CoreyChen922/rggber-hw/README.md

# rggber-hw
Schematics and Bill of Material

- ## rggber-hw/FPGA_CORE_BOARD

  FPGA processor board

- ## rggber-hw/IMAGE_BASE_BOARD

  Image mainboard

- ## rggber-hw/LCD_add_on

  LCD add-on card

- ## rggber-hw/iXCtrl_add_on

  iXCtrl add-on card

- ## RGGBer board level diagram

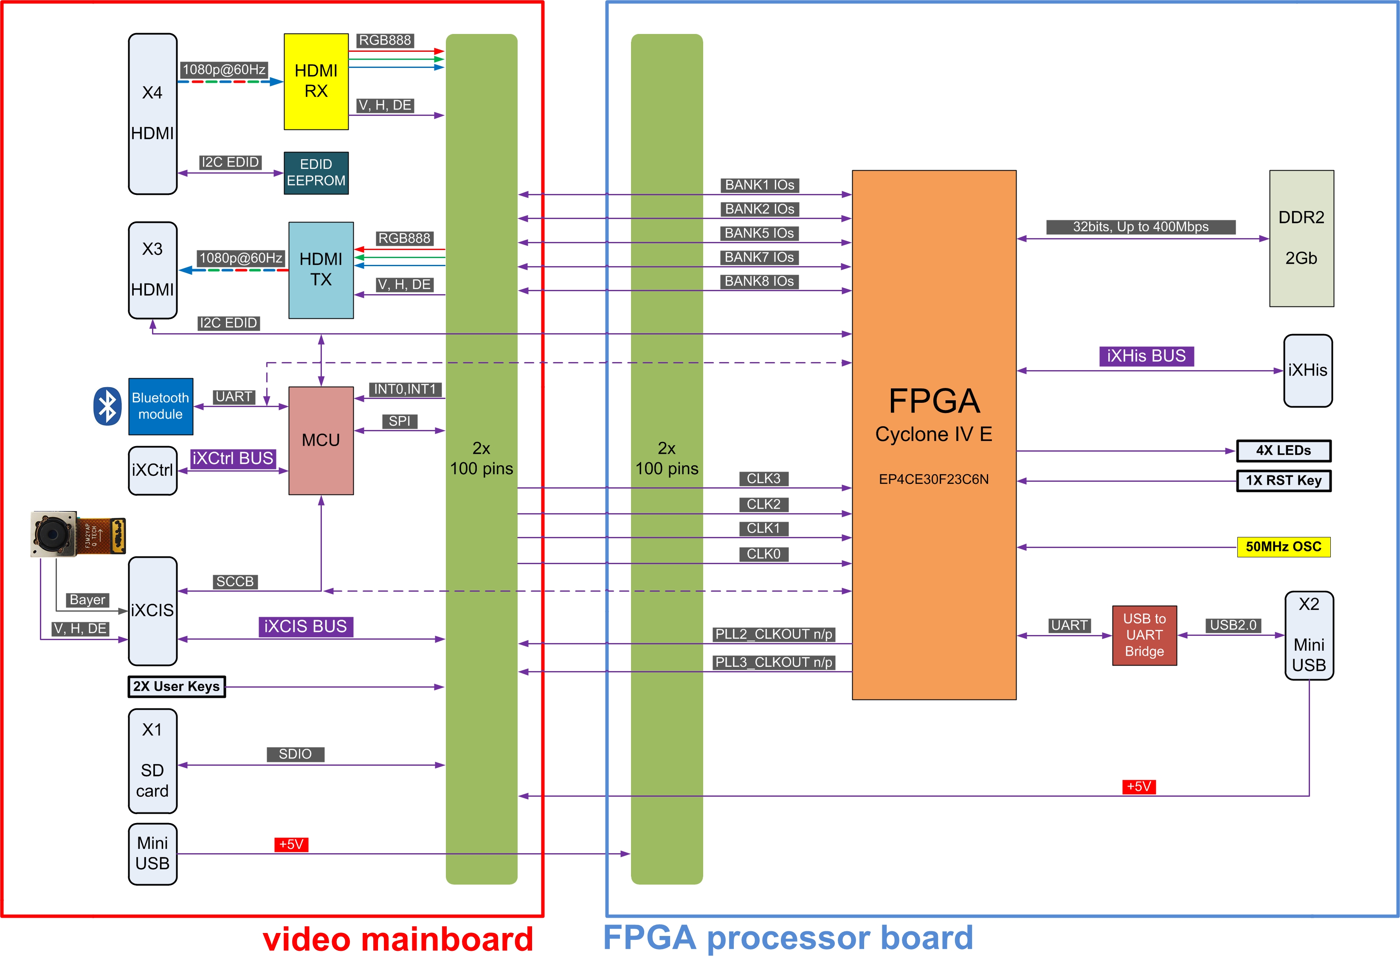
[picture p1: board-level-v3.jpg]
