CoreyChen922/rggber-hw/iXCtrl_add_on/BOM/0100_01_510020_003.xlsx

Description | Designator | Manufacturer1 | PartNumberManufacturer1 | Manufacturer2 | PartNumberManufacturer2 | Quantity
SMA,female,50ohm,right angle,TH | J1, J3, J5, J6 | OUPIIN | 8928-A0150G00RA |  |  | 4
DC jack,2.0mm,SMD | J2 | OUPIIN | 8963-2003ADTC |  |  | 1
FFC socket,10-Pin,bottom contact,0.5mm Pitch,SMD | J4 |  |  |  |  | 1
