CoreyChen922/rggber-hw/LCD_add_on/BOM/0100_01_510020_002.xlsx

Designator | Description | Manufacturer1 | PartNumberManufacturer1 | Manufacturer2 | PartNumberManufacturer2 | Quantity
C1 | CAP,Ceramic,X7R,10%,6.3V,22uF,0603 |  |  |  |  | 1
C2 | CAP,Ceramic,X7R,10%,25V,1uF,0805 |  |  |  |  | 1
C3 | CAP,Ceramic,X7R,10%,50V,47nF,0603 |  |  |  |  | 1
C4, C6, C7 | CAP,Ceramic,X7R,10%,16V,1uF,0603 |  |  |  |  | 3
C5 | CAP,Ceramic,X7R,10%,50V,0.01uF,0603 |  |  |  |  | 1
D1 | Schottky Barrier Rectifier,40V,3A,SMA | ONsemi | MBRA340T3G | Diodes | B340A-13-F | 1
J1 | FFC socket,50-Pin,top contact,0.5mm Pitch,SMD | TBD | FPC0.5mm-50pin |  |  | 1
J2 | FFC socket,54-Pin,bottom contact,0.5mm Pitch,SMD | TBD | FPC0.5mm-54pin |  |  | 1
L1 | Inductor,10uH,700mA,0.22ohm,SMD | TAIYO YUDEN | NRS3015T100MNGH |  |  | 1
R1 | RES,1k,1%,1/10W,0603 |  |  |  |  | 1
R2 | RES,10R,1%,1/8W,0805 |  |  |  |  | 1
R3 | RES,4.7k,1%,1/10W,0603 |  |  |  |  | 1
U1 | IC, boost converter, 1.1A, TSOT23-6 | SGM | SGM3726YTN6G |  |  | 1
U2 | IC,LDO 3.3V@300mA,SOT23-5 | SGM | SGM2019-3.3YN5G |  |  | 1
