CoreyChen922/rggber-hw/FPGA_CORE_BOARD/BOM/0100_01_510020_000.xlsx

Description | Designator | Manufacturer1 | PartNumberManufacturer1 | Manufacturer2 | PartNumberManufacturer2 | Quantity
Bead,100R,2500mA,0.035ohm,0603 | B1, B2 | YAIYO YUDEN | FBMH1608HM101-T |  |  | 2
CAP,Ceramic,X7R,10%,16V,0.1uF,0402 | C1, C19, C20, C22, C23, C24, C25, C26, C27, C28, C29, C30, C31, C32, C33, C34, C35, C36, C37, C38, C39, C40, C41, C42, C43, C44, C45, C46, C47, C48, C49, C50, C51, C52, C53, C54, C55, C56, C57, C58, C59, C60, C61, C62, C65, C66, C67, C68, C71, C72, C73, C74, C75, C76, C77, C78, C79, C80, C81, C82 |  |  |  |  | 60
CAP,Ceramic,X7R,10%,6.3V,10uF,0603 | C2, C7, C10, C13, C18, C63, C64, C69, C70 |  |  |  |  | 9
CAP,Ceramic,X7R,10%,6.3V,22uF,0603 | C3, C4, C5, C6, C8, C9, C11, C12, C16, C17 |  |  |  |  | 10
CAP,Ceramic,X7R,10%,16V,1uF,0603 | C14, C15, C21 |  |  |  |  | 3
Schottky Barrier Rectifier,20V,3A,SMA | D1 | Onsemi | MBRA320T3G | Diodes | B320A-13-F | 1
TVS array,0.9pF,5V,SC89 | D2 | SEMTECH | RClamp0502A |  |  | 1
LED,Yellow Green,2V,20mA,0603 | D3, D4, D12 |  |  |  |  | 3
LED,Blue,3.4V,20mA,0603 | D5 |  |  |  |  | 1
LED,Yellow,2V,20mA,0603 | D6 |  |  |  |  | 1
LED,Super Red,2V,20mA,0603 | D7 |  |  |  |  | 1
Schottky Double Diodes,30V,200mA,SOT23,a1k2k1a2 | D8, D9, D10, D11, D13 | NXP | BAT54S |  |  | 5
B2B female,100Pin,Vertical,0.8mm Pitch,SMD | J1, J2 | JK | 3710F100037XX |  |  | 2
Header,4Pin,Vertical,1.27mm Pitch,SMD | J3 |  |  |  |  | 1
Mini-USB Receptacle,5-Pin,0.8mm Pitch,SMD | J4 | Leyconn | 434254XXXX00 |  |  | 1
FFC socket,50-Pin,Vertical,0.5mm Pitch,SMD | J5 | XinHongNuo | FPC050A013 |  |  | 1
Header,10Pin,Vertical,2.54mm Pitch,TH | J6 |  |  |  |  | 1
Inductor,1.0uH,2100mA,0.03ohm,SMD | L1, L2, L3, L4 | TAIYO YUDEN | NR3015T1R0N |  |  | 4
RES,10k,1%,1/16W,0402 | R1, R2, R46, R47, R48, R50, R52, R53, R57 |  |  |  |  | 9
RES,100k,1%,1/16W,0402 | R3, R7, R11, R14, R15 |  |  |  |  | 5
RES,499k,1%,1/16W,0402 | R4, R8, R12, R16 |  |  |  |  | 4
RES,200k,1%,1/16W,0402 | R5, R6, R9, R13, R17 |  |  |  |  | 5
RES,44.2k,1%,1/16W,0402 | R10 |  |  |  |  | 1
RES,82k,1%,1/16W,0402 | R18 |  |  |  |  | 1
RES,63.2k,1%,1/16W,0402 | R19 |  |  |  |  | 1
RES,51k,1%,1/16W,0402 | R20 |  |  |  |  | 1
RES,47k,1%,1/16W,0402 | R21 |  |  |  |  | 1
RES,330R,1%,1/16W,0402 | R22, R26, R27, R28, R29, R58 |  |  |  |  | 6
RES,4.7k,1%,1/16W,0402 | R23 |  |  |  |  | 1
RES,49R9,1%,1/16W,0402 | R24, R25 |  |  |  |  | 2
RES,100R,1%,1/16W,0402 | R30, R31, R32, R33, R34, R35, R36, R37, R38, R39, R40, R41, R42, R43, R44, R45, R51, R59 |  |  |  |  | 18
RES,33R,1%,1/16W,0402 | R49, R54, R56 |  |  |  |  | 3
RES,1k,1%,1/16W,0402 | R55 |  |  |  |  | 1
Switch,3.5x2.9,Normal open,SMD | S1 | Panasonic | EVQP7A01K |  |  | 1
IC,DC/DC,2A,1.2MHz,TSOT23-8 | U1, U2, U3, U5 | MPS | MP2144GJ |  |  | 4
IC,LDO 500mA,Adjustable,SOT23-5 | U4 | SGM | SGM2028-ADJYN5G |  |  | 1
IC,USB to UART bridge,QFN28 | U6 | Silicon Labs | CP2102-GM |  |  | 1
IC,FPGA,28848 LEs,Speed-6,FBGA484 | U7 | ALTERA | EP4CE30F23C6N |  |  | 1
IC,OSC,50MHz,3.3V,100ppm,3225 | U8 | KDS | DSO321SRAA-50MHz |  |  | 1
IC,FLASH,64 Mbit,SPI,VDFPN8 | U9 | Micron/ST | M25P64VME6TP |  |  | 1
IC,DDR2 SDRAM,64Mx16,FBGA84 | U10, U11 | Micron | MT47H64M16HR-25E |  |  | 2
