CoreyChen922/rggber-hw/IMAGE_BASE_BOARD/BOM/0100_01_510020_001.xlsx

Description | Designator | Manufacturer1 | PartNumberManufacturer1 | Manufacturer2 | PartNumberManufacturer2 | Quantity
Bead,100R,2500mA,0.035ohm,0603 | B1, B2, B3, B4, B5, B6, B7 | YAIYO YUDEN | FBMH1608HM101-T |  |  | 7
CAP,Ceramic,X7R,10%,16V,1uF,0603 | C1, C31, C33, C34, C36, C37, C38 |  |  |  |  | 7
CAP,Ceramic,X7R,10%,6.3V,10uF,0603 | C2, C3, C7, C12, C18, C22, C26, C29 |  |  |  |  | 8
CAP,Ceramic,X7R,10%,16V,0.1uF,0402 | C4, C5, C6, C8, C9, C10, C11, C13, C14, C15, C16, C17, C19, C20, C21, C23, C24, C25, C27, C28, C30, C39, C40, C42, C44, C45, C46, C47 |  |  |  |  | 28
CAP,Ceramic,X7R,10%,16V,0.01uF,0402 | C32, C35 |  |  |  |  | 2
CAP,Ceramic,X5R,10%,6.3V,4.7uF,0603 | C41, C43 |  |  |  |  | 2
TVS array,0.3pF,5V,SLP2510P8 | D1, D2, D7, D8 | SEMTECH | RClamp0524P |  |  | 4
TVS array,1pF,5V,SC75 | D3, D4, D6, D9, D10, D11 | SEMTECH | RClamp0502B |  |  | 6
Schottky Double Diodes,30V,200mA,SOT23,a1a2k1k2 | D5 | NXP | BAT54C |  |  | 1
Schottky Double Diodes,30V,200mA,SOT23,a1k2k1a2 | D12, D13 | NXP | BAT54S |  |  | 2
Zener Diodes,3.0V,5mA,2%,SOD123 | D14 | DIODES | BZT52C3V0 |  |  | 1
LED,Yellow Green,2V,20mA,0603 | D15, D16 |  |  |  |  | 2
Mini-USB Receptacle,5-Pin,0.8mm Pitch,SMD | J1 | Leyconn | 434254XXXX00 |  |  | 1
Header,HDMI type C,19-Pin,Right angle,0.4mm Pitch,SMD | J2, J3 | YTCO | 6531-19FHXXXXX01X |  |  | 2
B2B male,100Pin,Vertical,0.8mm Pitch,SMD | J4, J5 | JK | 3710M100046XX |  |  | 2
FFC socket,24-Pin,bottom contact,0.5mm Pitch,SMD | J6 | TBD | FPC0.5mm -nP H2.0mm |  |  | 1
FFC socket,10-Pin,bottom contact,0.5mm Pitch,SMD | J7 |  |  |  |  | 1
Header,10Pin,Vertical,2.54mm Pitch,TH | J8 |  |  |  |  | 1
micro SD card header, detect pin, SMD | J9 | Molex | 473092651 |  |  | 1
TRANSISTOR,NPN,40V,500mA,SOT23 | Q1 | JiangSu CJ | S9013 |  |  | 1
MOSFET,N Channel,3.16A,30V,SOT23 | Q2 | JCET | CJ2306 |  |  | 1
RES,4.7k,1%,1/16W,0402 | R1, R10, R11, R12, R13, R18, R24, R36, R37, R38, R39, R41, R42, R43, R44, R45 |  |  |  |  | 16
RES,1k,1%,1/16W,0402 | R2, R6, R7, R8, R16, R20, R25, R26, R27, R28, R29, R31, R32, R33, R40, R46, R47 |  |  |  |  | 17 | R2,R15不安装
RES,33R,1%,1/16W,0402 | R3, R4, R5, R14, R15, R19 |  |  |  |  | 6
RES,200k,1%,1/16W,0402 | R9, R21, R35, R48 |  |  |  |  | 4
RES,0R,1%,1/16W,0402 | R17 |  |  |  |  | 1
RES,510R,1%,1/16W,0402 | R22, R49 |  |  |  |  | 2
RES,5.1k,1%,1/16W,0402 | R23 |  |  |  |  | 1
RES,63.4k,1%,1/16W,0402 | R30 |  |  |  |  | 1
RES,47k,1%,1/16W,0402 | R34 |  |  |  |  | 1
RES,100k,1%,1/16W,0402 | R50 |  |  |  |  | 1
RES,200R,1%,1/16W,0402 | R51, R52 |  |  |  |  | 2
RES,10k,1%,1/16W,0402 | R53, R54, R55, R56, R57, R58 |  |  |  |  | 6
Switch,3.5x2.9,Normal open,SMD | S1, S2 | Panasonic | EVQP7A01K |  |  | 2
IC,LDO,1000mA,3.3V,SOT223 | U1 | Ti | TLV1117LV33DCY |  |  | 1
IC,PanelBus Digital Receiver,HTQFP100 | U2 | Ti | TFP401APZP |  |  | 1
IC,I2C-bus and SMBus voltage-level translator,SOT23-8 | U3, U9 | SGM | SGM4551YN8G |  |  | 2
IC,EEPROM,512X8bits,I2C,SOIC8 | U4 | Microchip | 24LC04B-I/SN |  |  | 1
IC,PanelBus Digital Transmitter,HTQFP64 | U5 | Ti | TFP410PAP |  |  | 1
IC,LDO 1.5V@300mA,SOT23-5 | U6 | SGM | SGM2019-1.5YN5G |  |  | 1
IC,LDO 3.0V@300mA,SOT23-5 | U7 | SGM | SGM2019-3.0YN5G |  |  | 1
IC,LDO 500mA,Adjustable,SOT23-5 | U8 | SGM | SGM2028-ADJYN5G |  |  | 1
IC,MCU,50MIPS,32K FLASH,12bits ADC,TQFP32 | U10 | Silicon Labs | C8051F410 |  |  | 1
Bluetooth module, UART, 18PIN, SMD | U11 | RF STAR | RF-BM-S02A |  |  | 1
