CoreyChen922/rggber-hw/iXCtrl_add_on/PDF/0100_01_510000_003.pdf

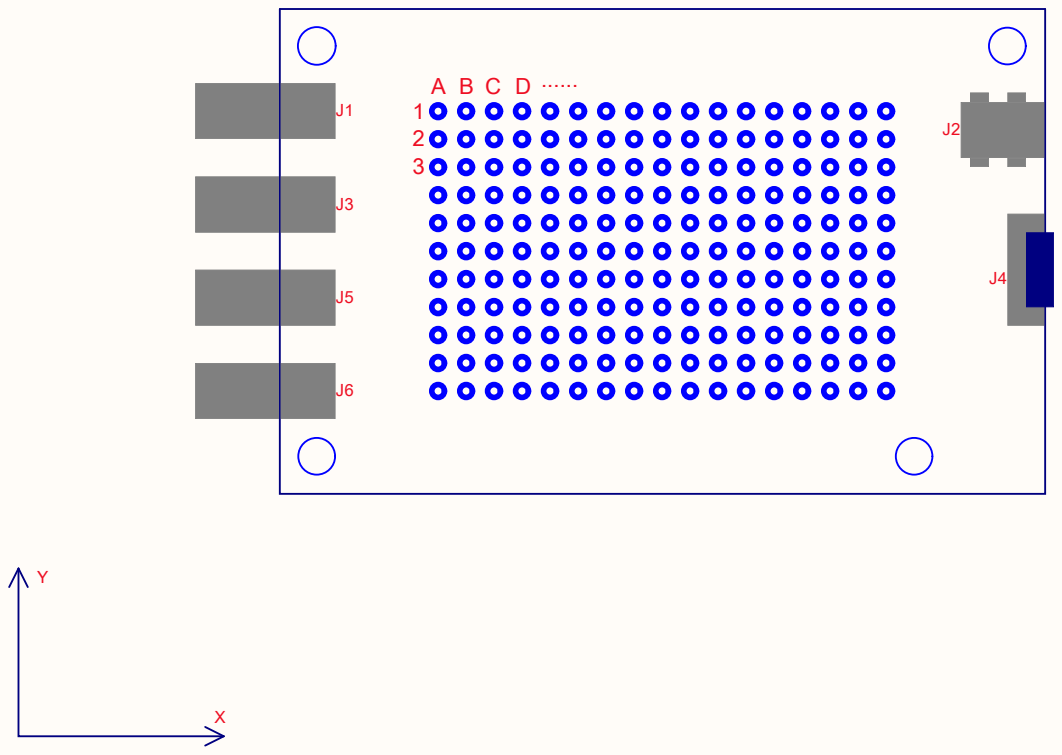
[picture p2: page 1]

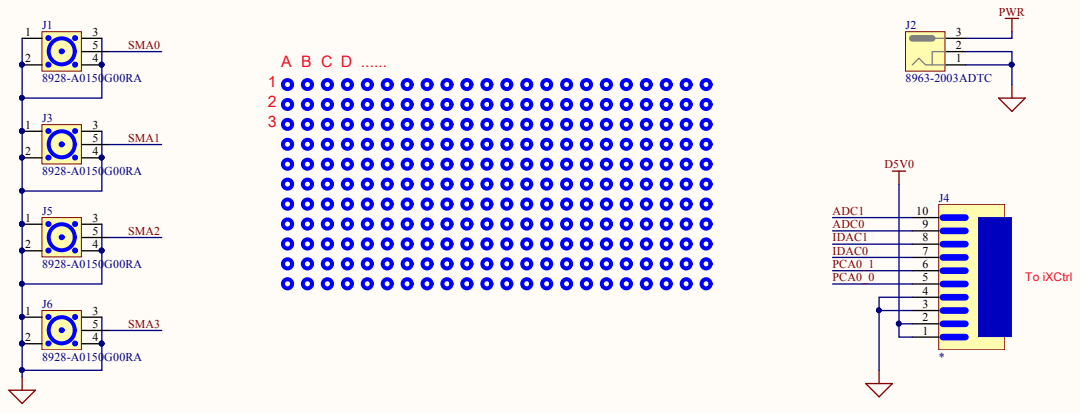
[picture p3: page 2]
