CoreyChen922/rggber-hw/LCD_add_on/PDF/0100_01_510000_002.pdf

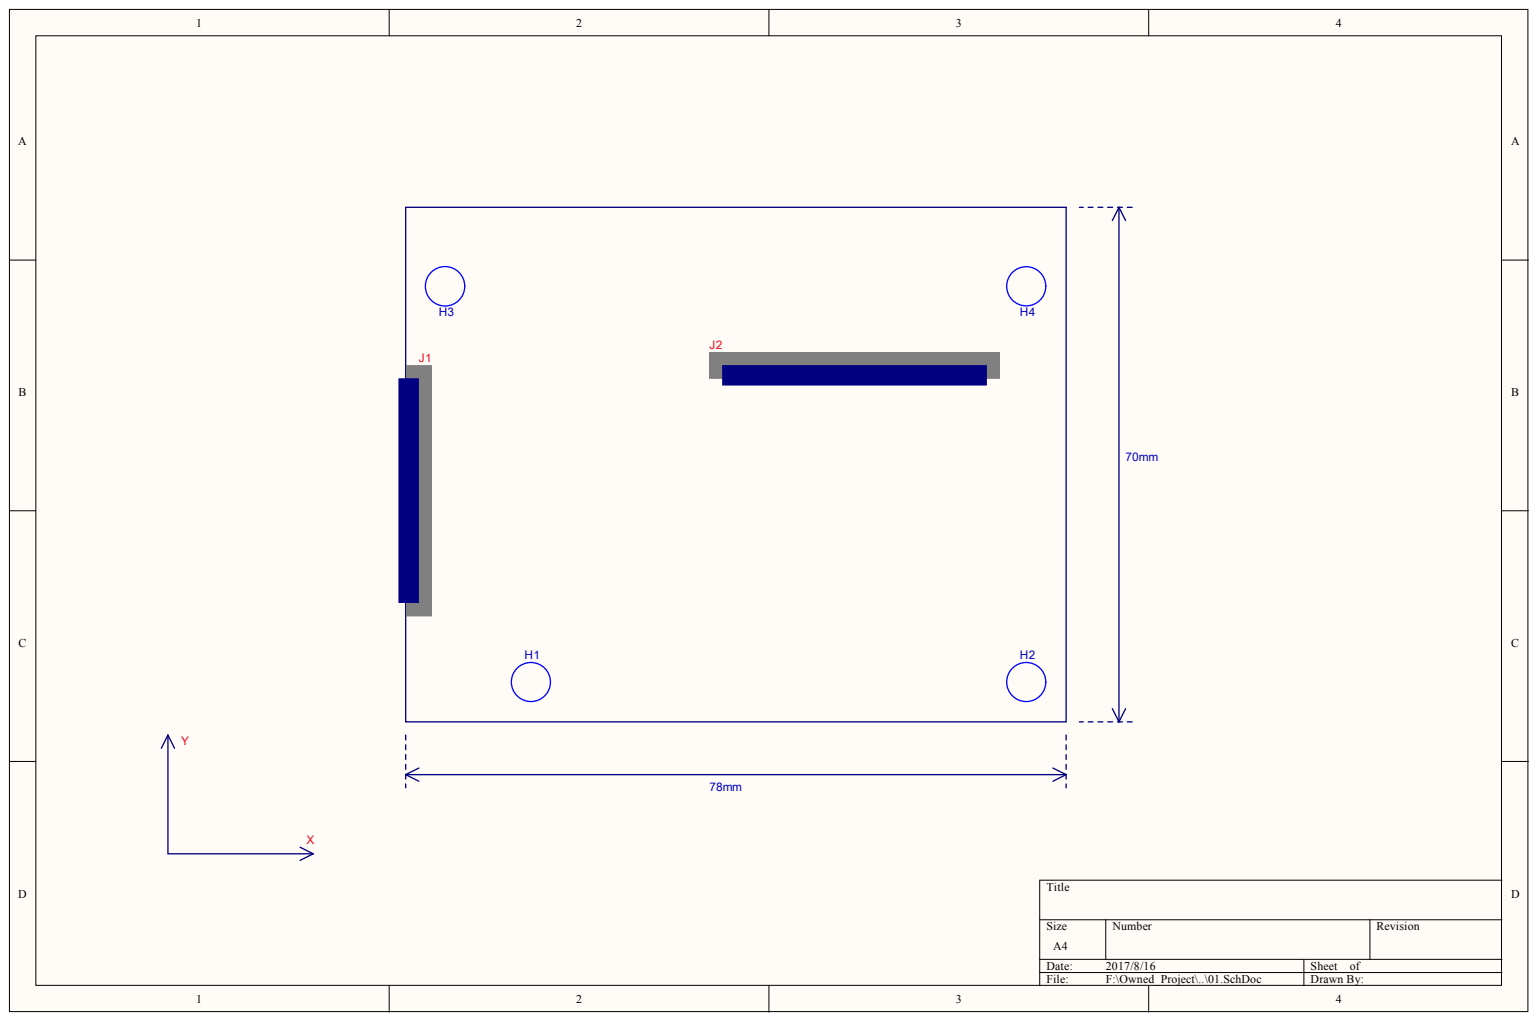
[picture p4: page 1]

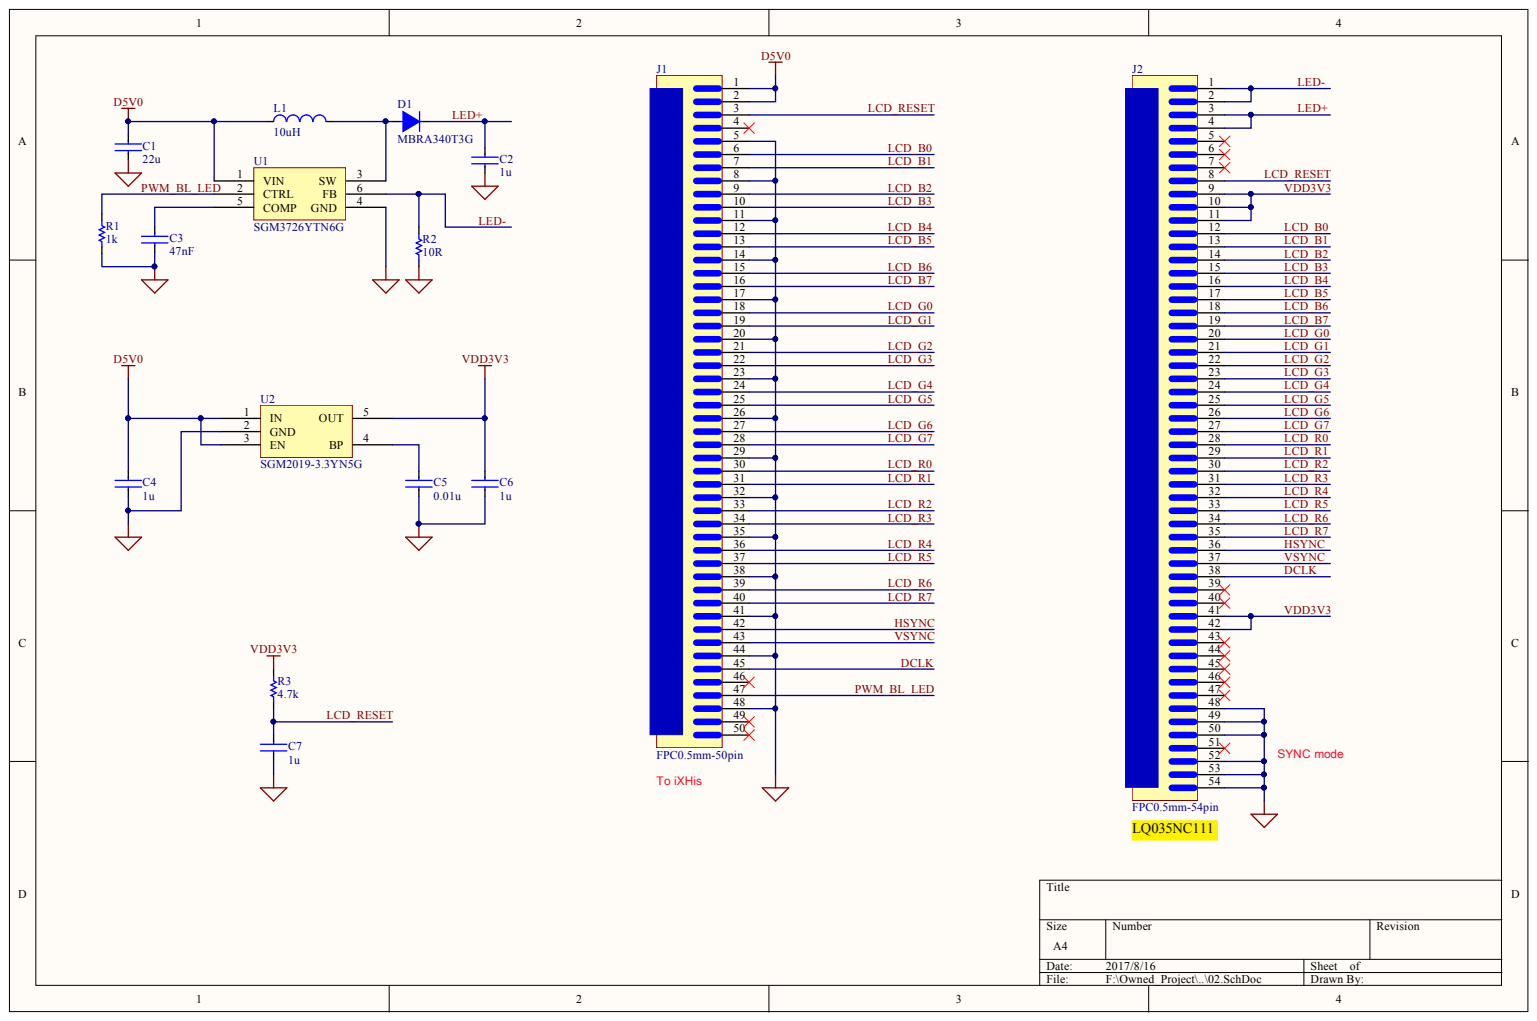
[picture p5: page 2]
