CoreyChen922/rggber-hw/FPGA_CORE_BOARD/PDF/0100_01_510010_000.pdf

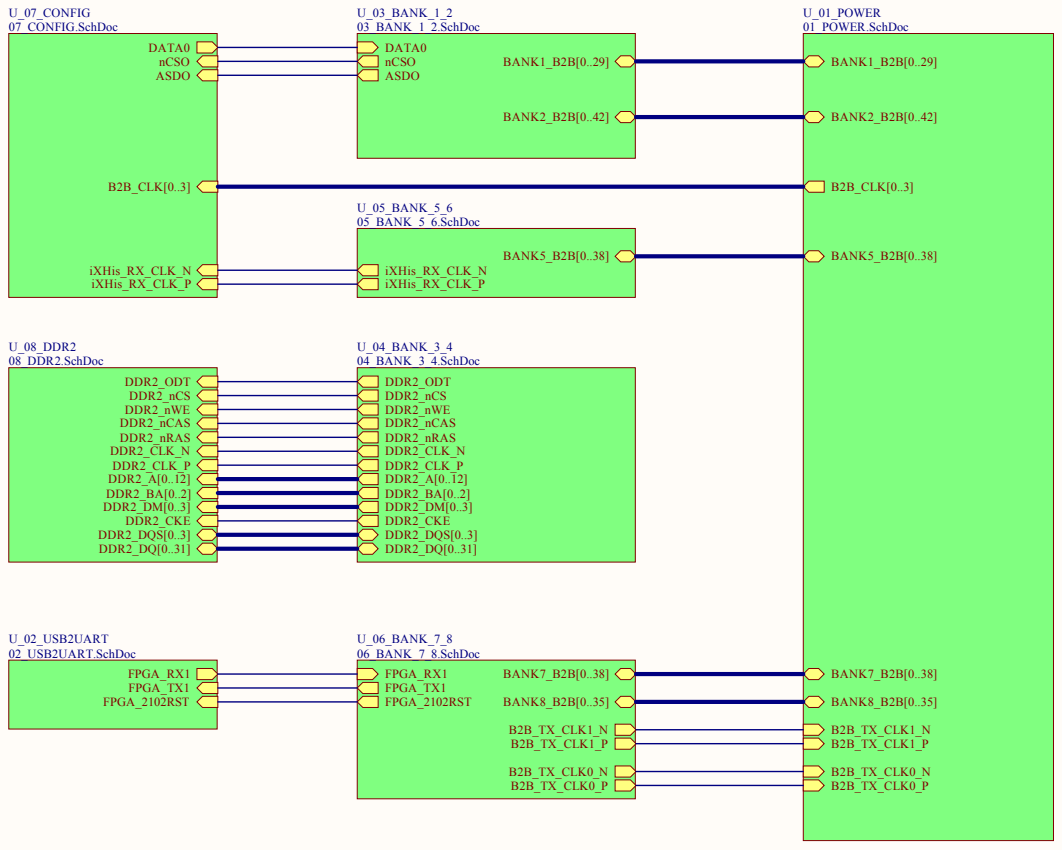
[picture p6: page 1]

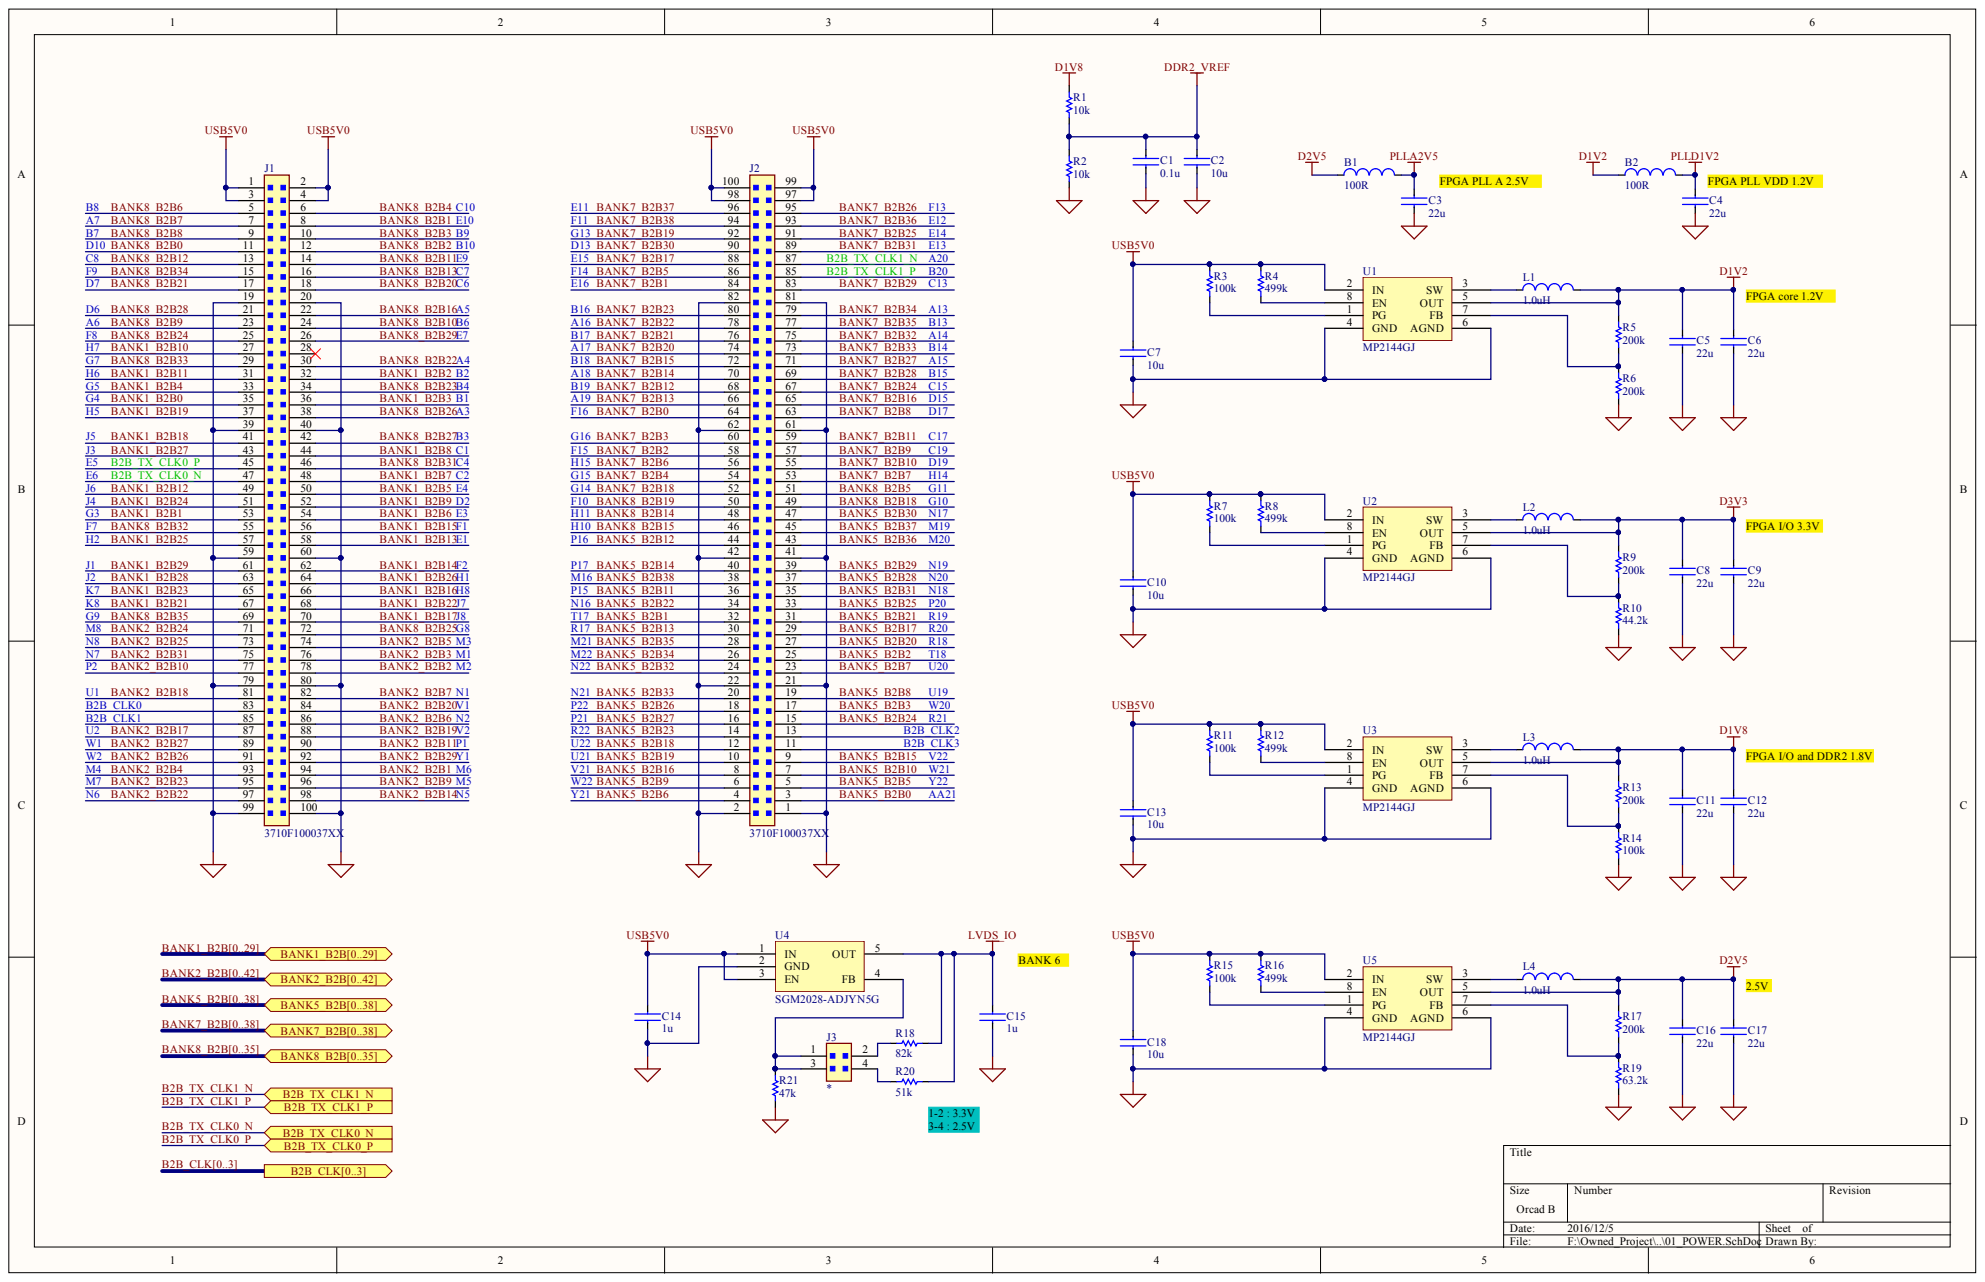
[picture p7: page 2]

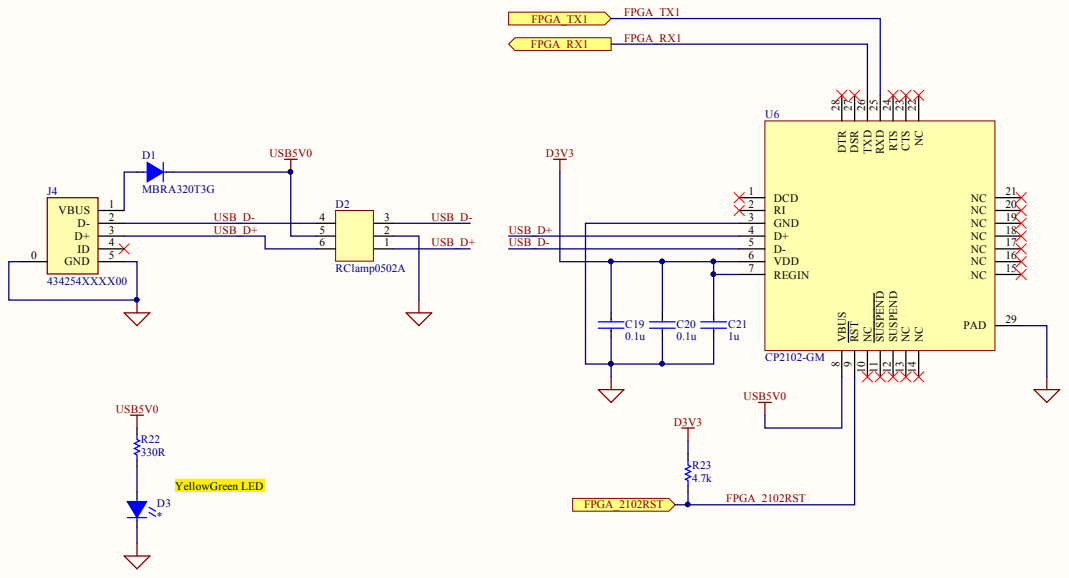
[picture p8: page 3]

NC 22 CTS 23 RTS 24 RXD 25 TXD 26 DSR 27 DTR 28

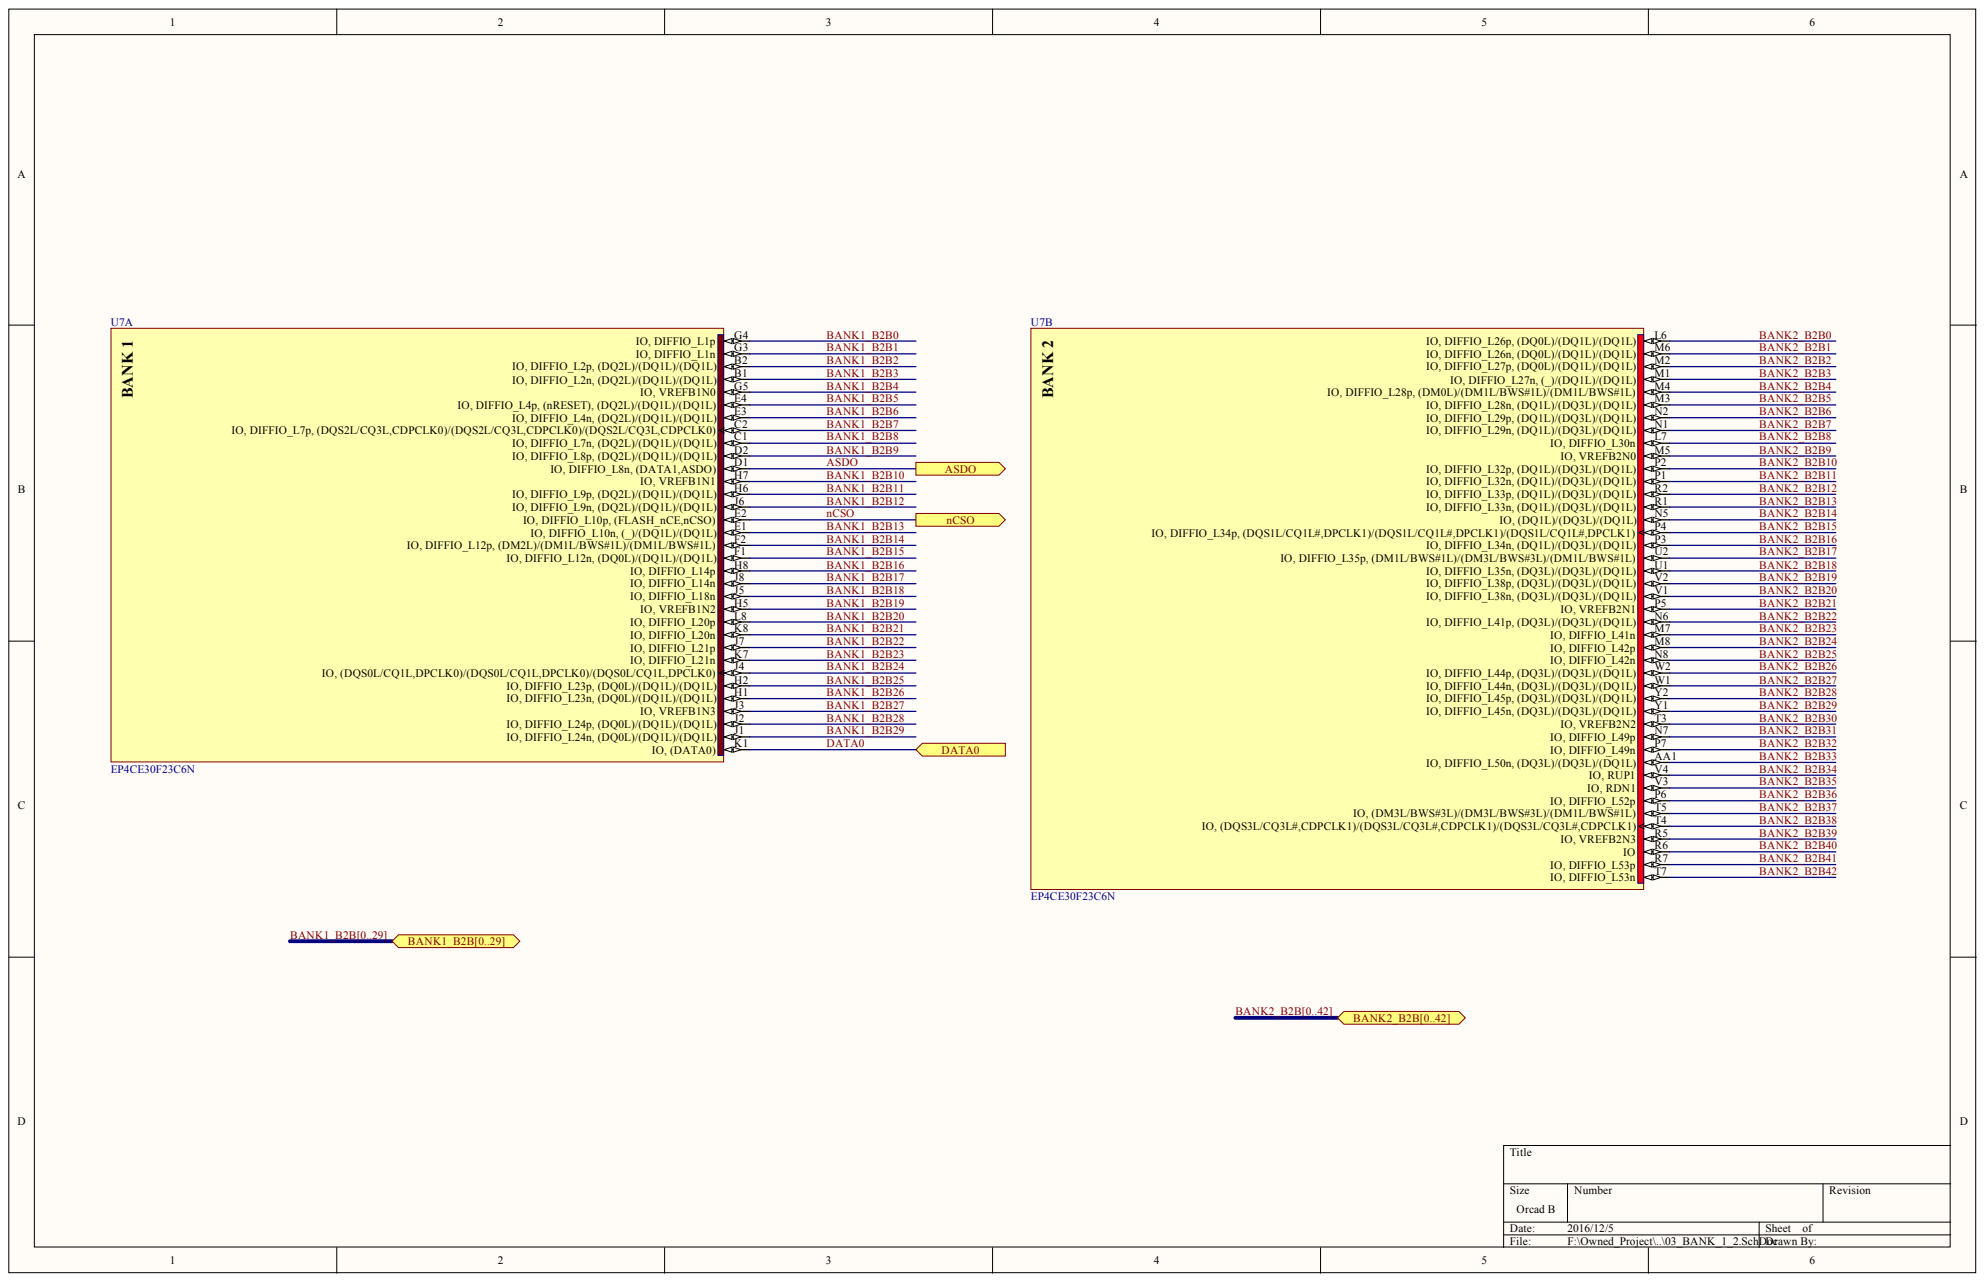
[picture p9: page 4]

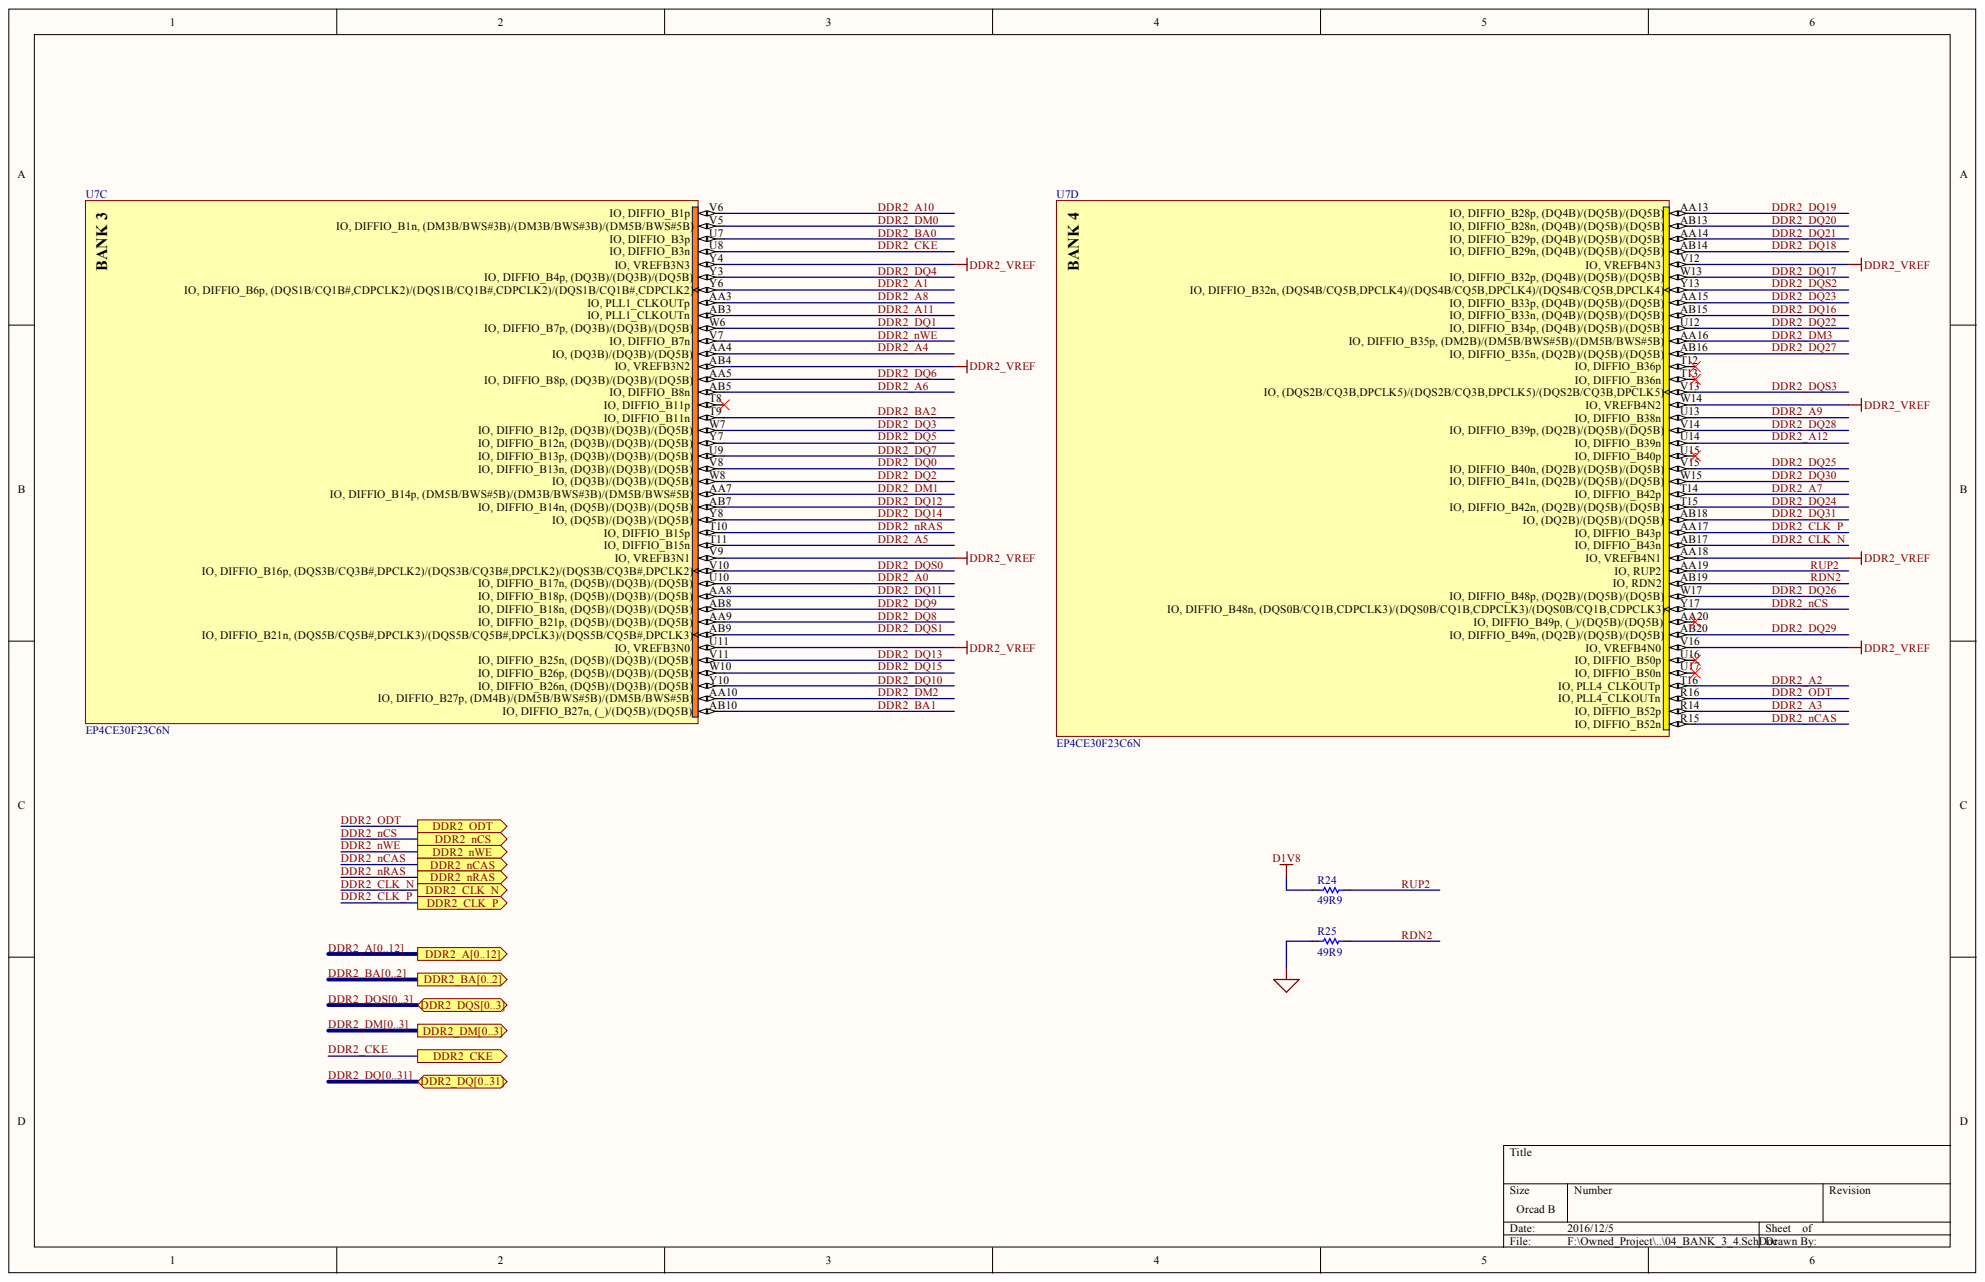
[picture p10: page 5]

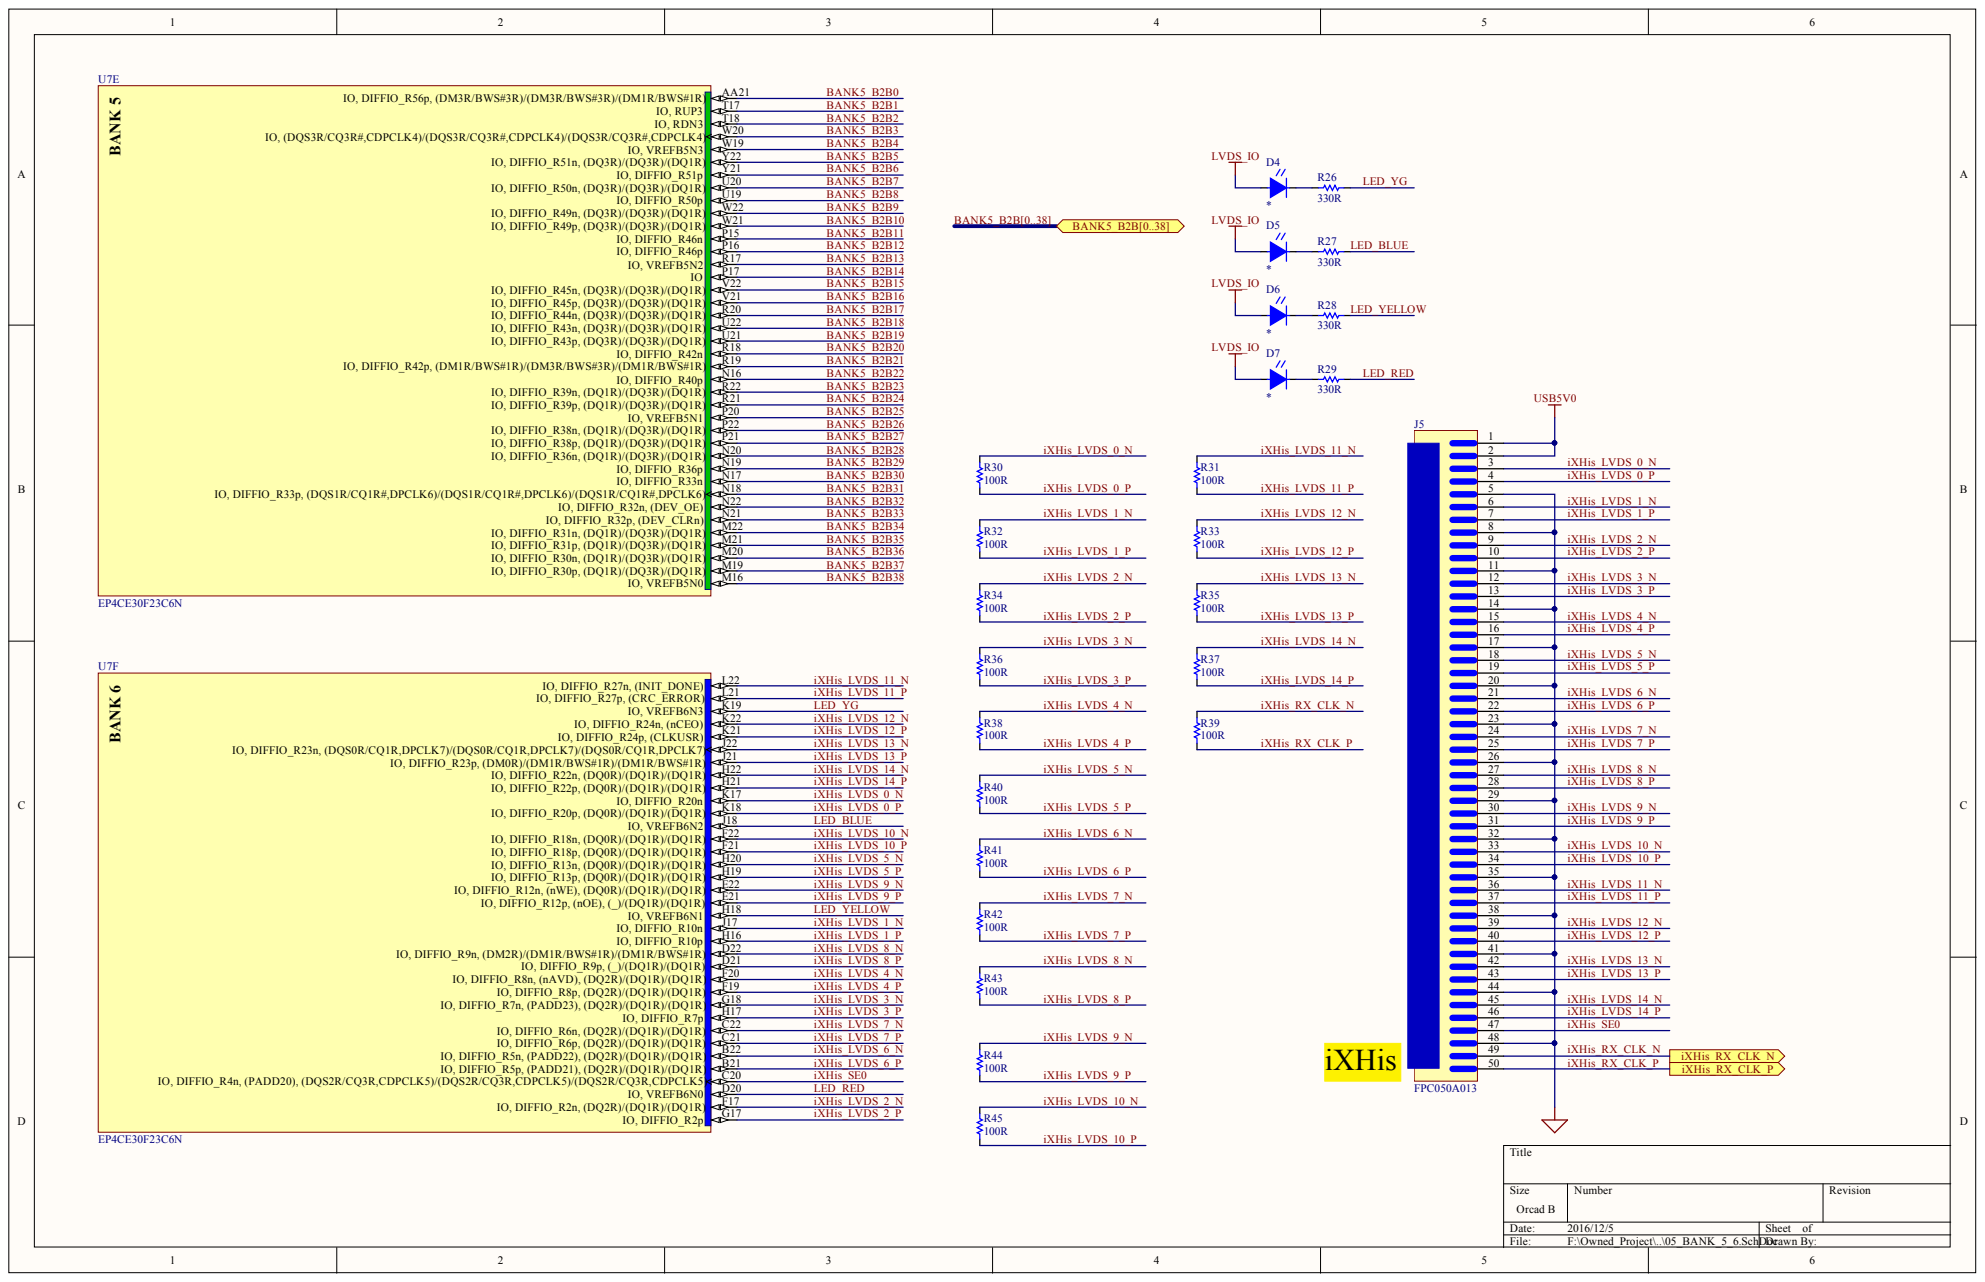
[picture p11: page 6]

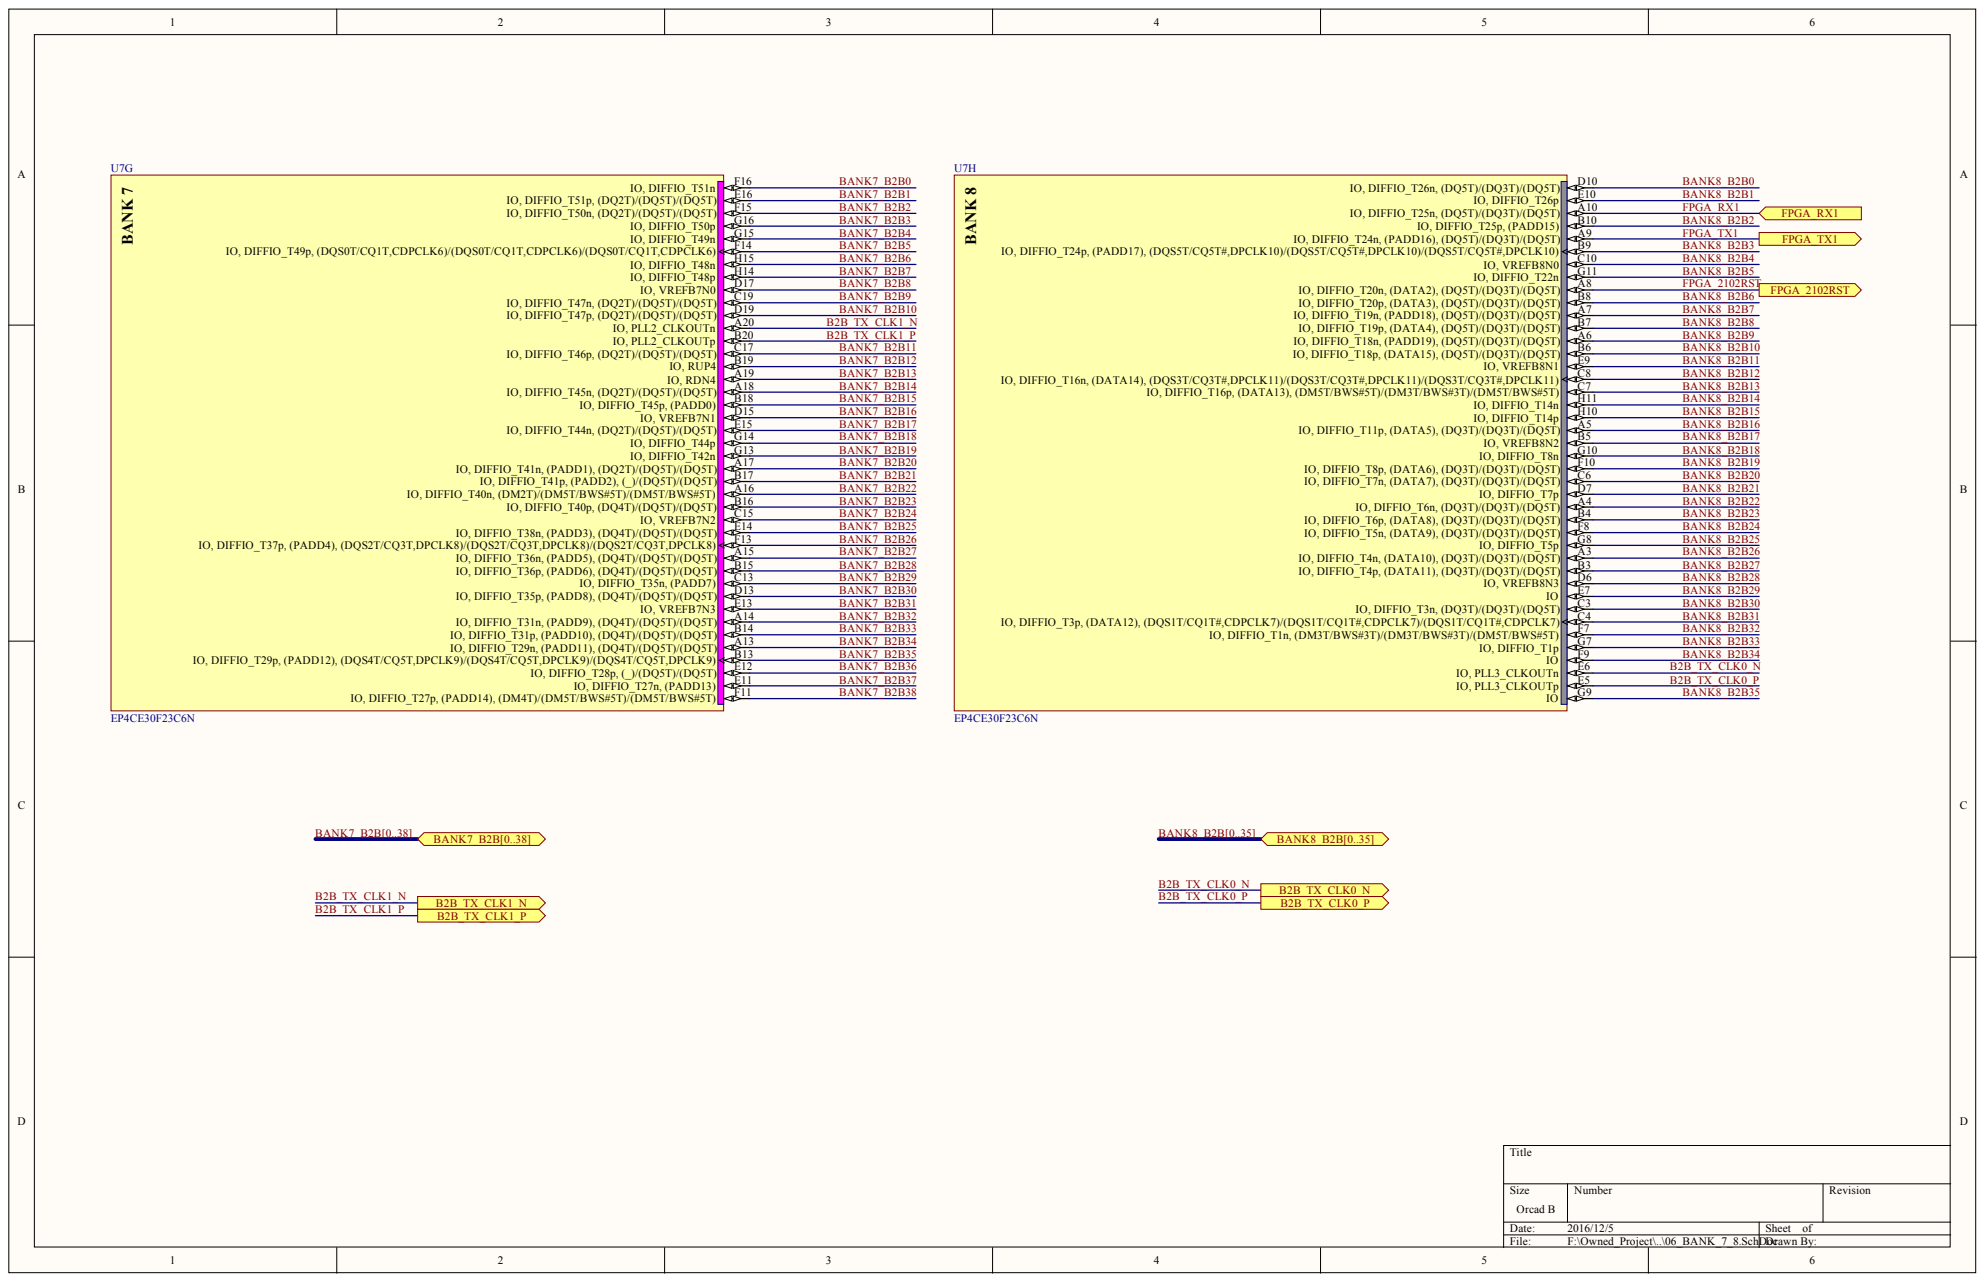
[picture p12: page 7]

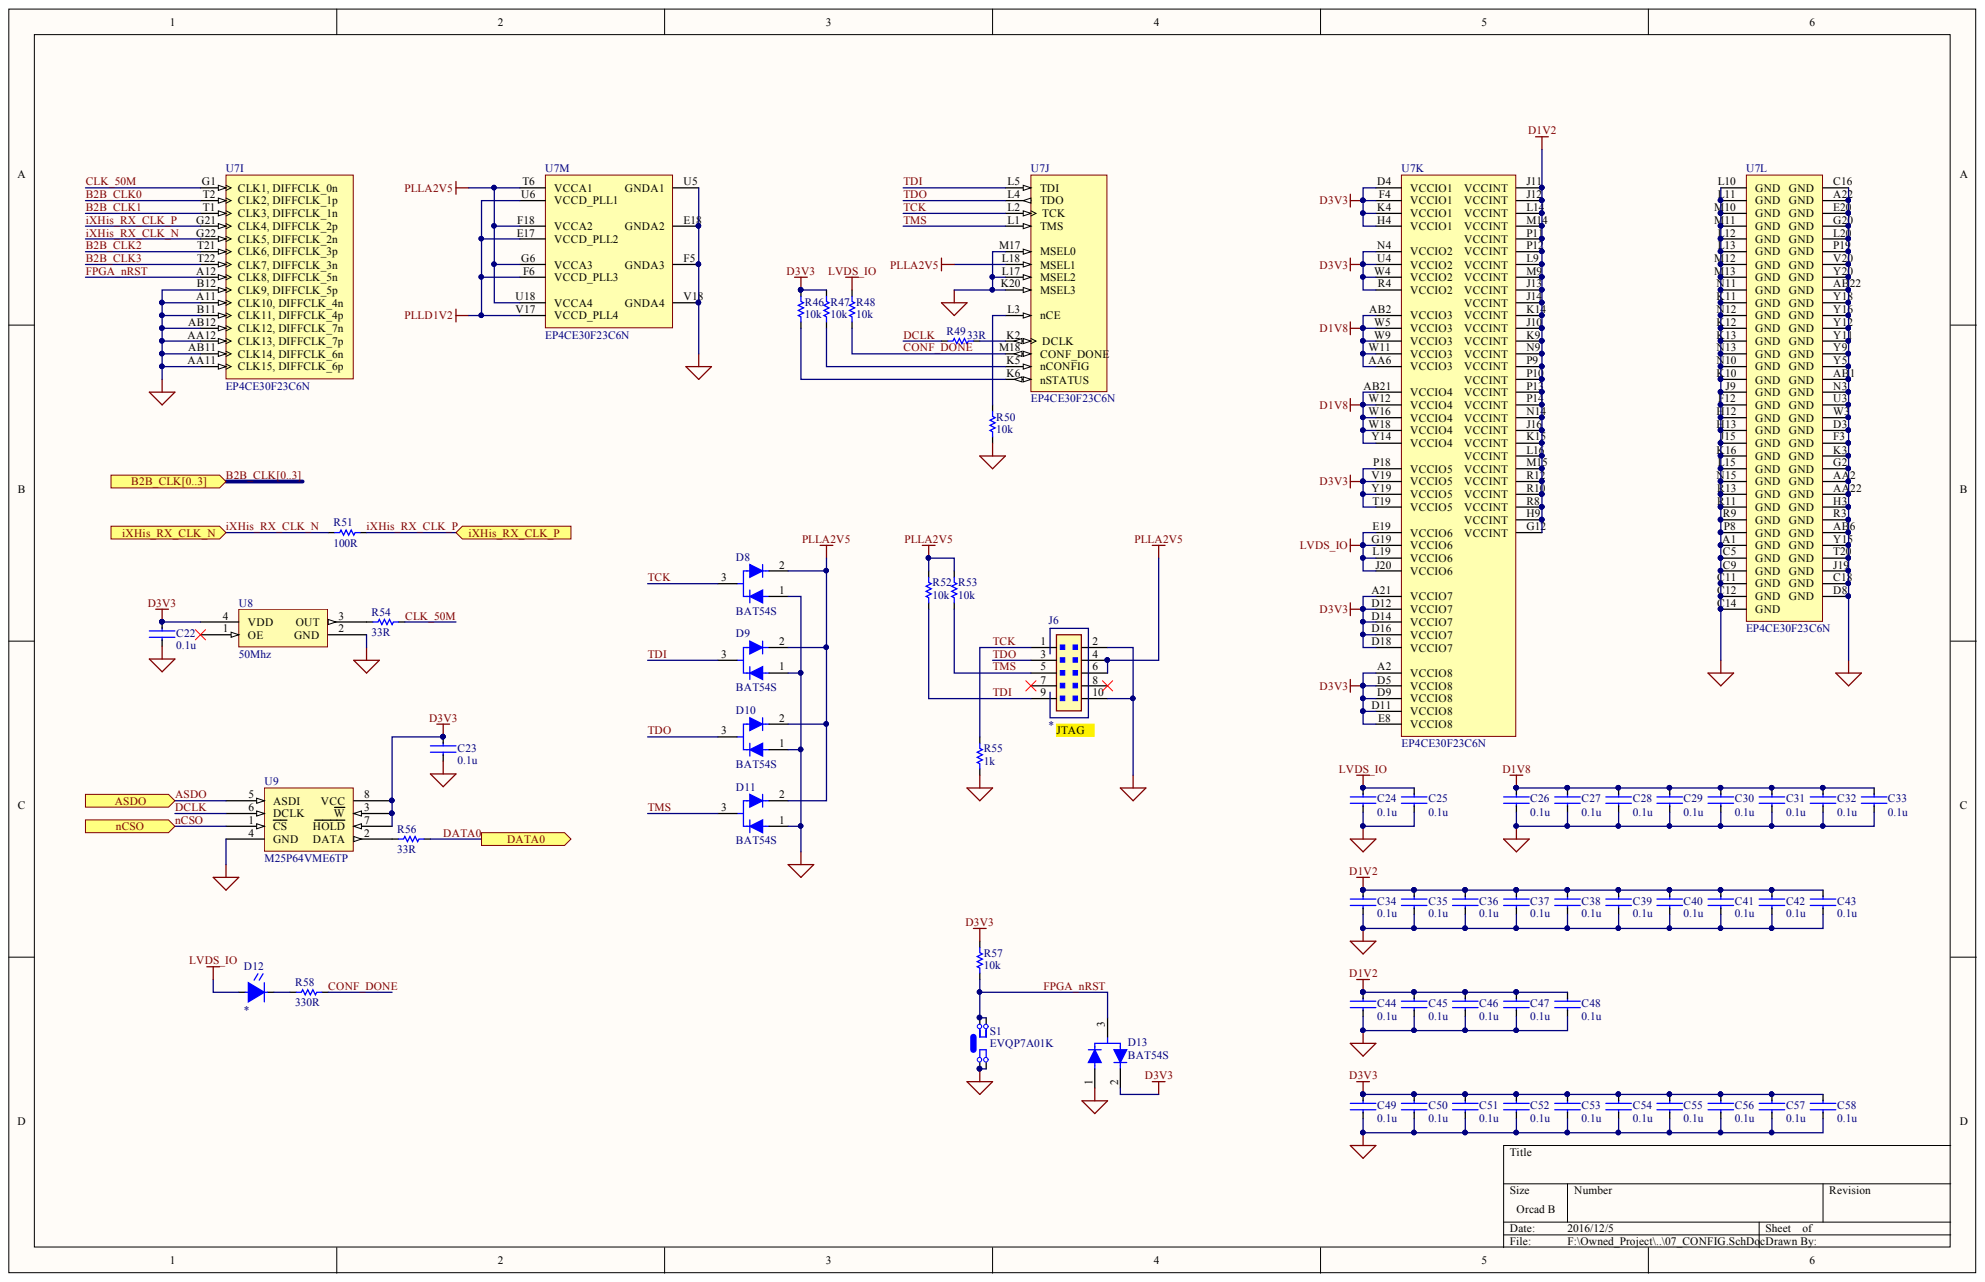
[picture p13: page 8]

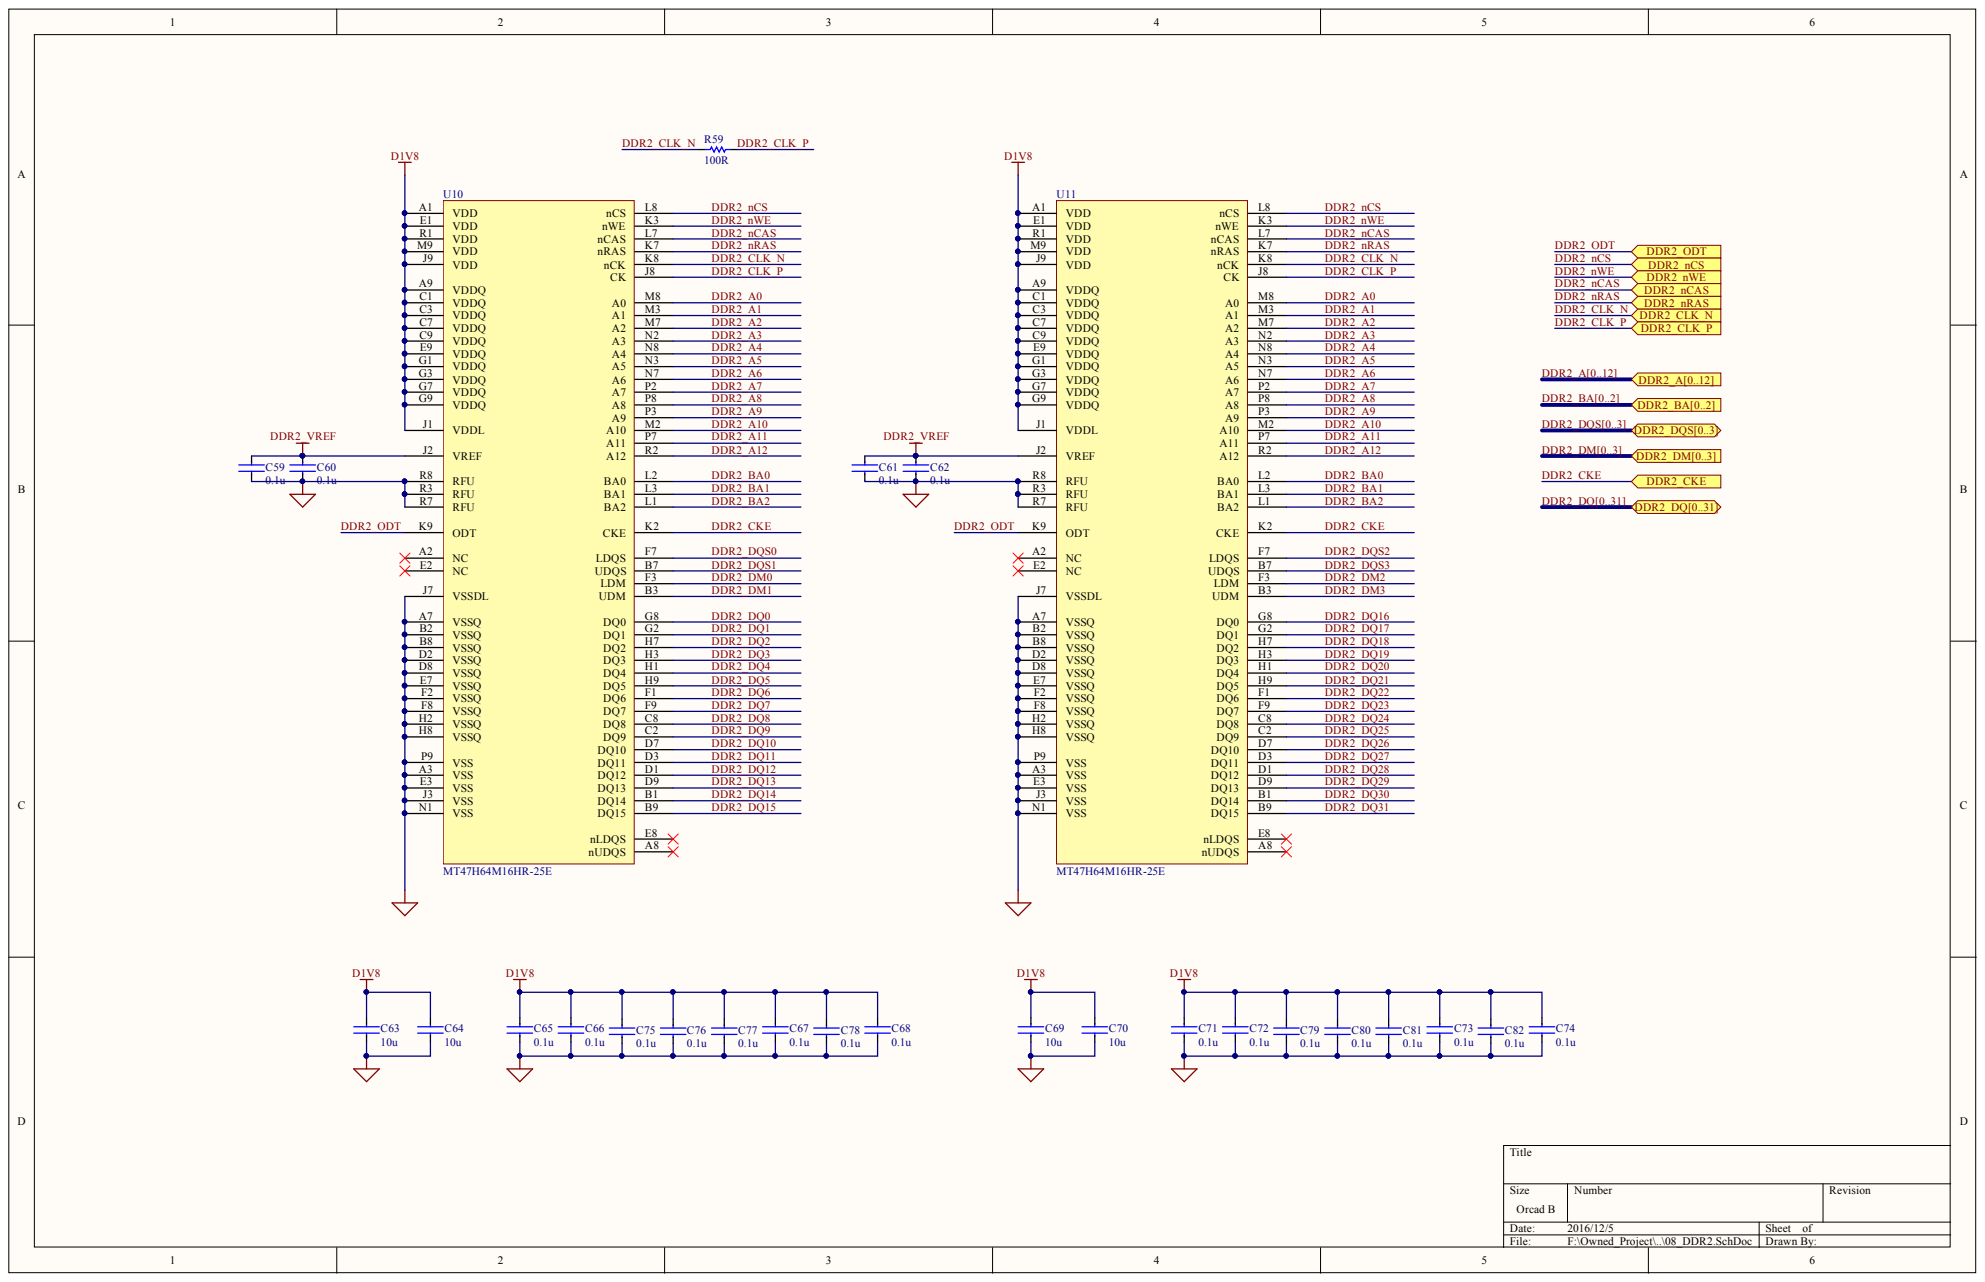
[picture p14: page 9]
