CoreyChen922/rggber-hw/IMAGE_BASE_BOARD/PDF/0100_01_510010_001.pdf

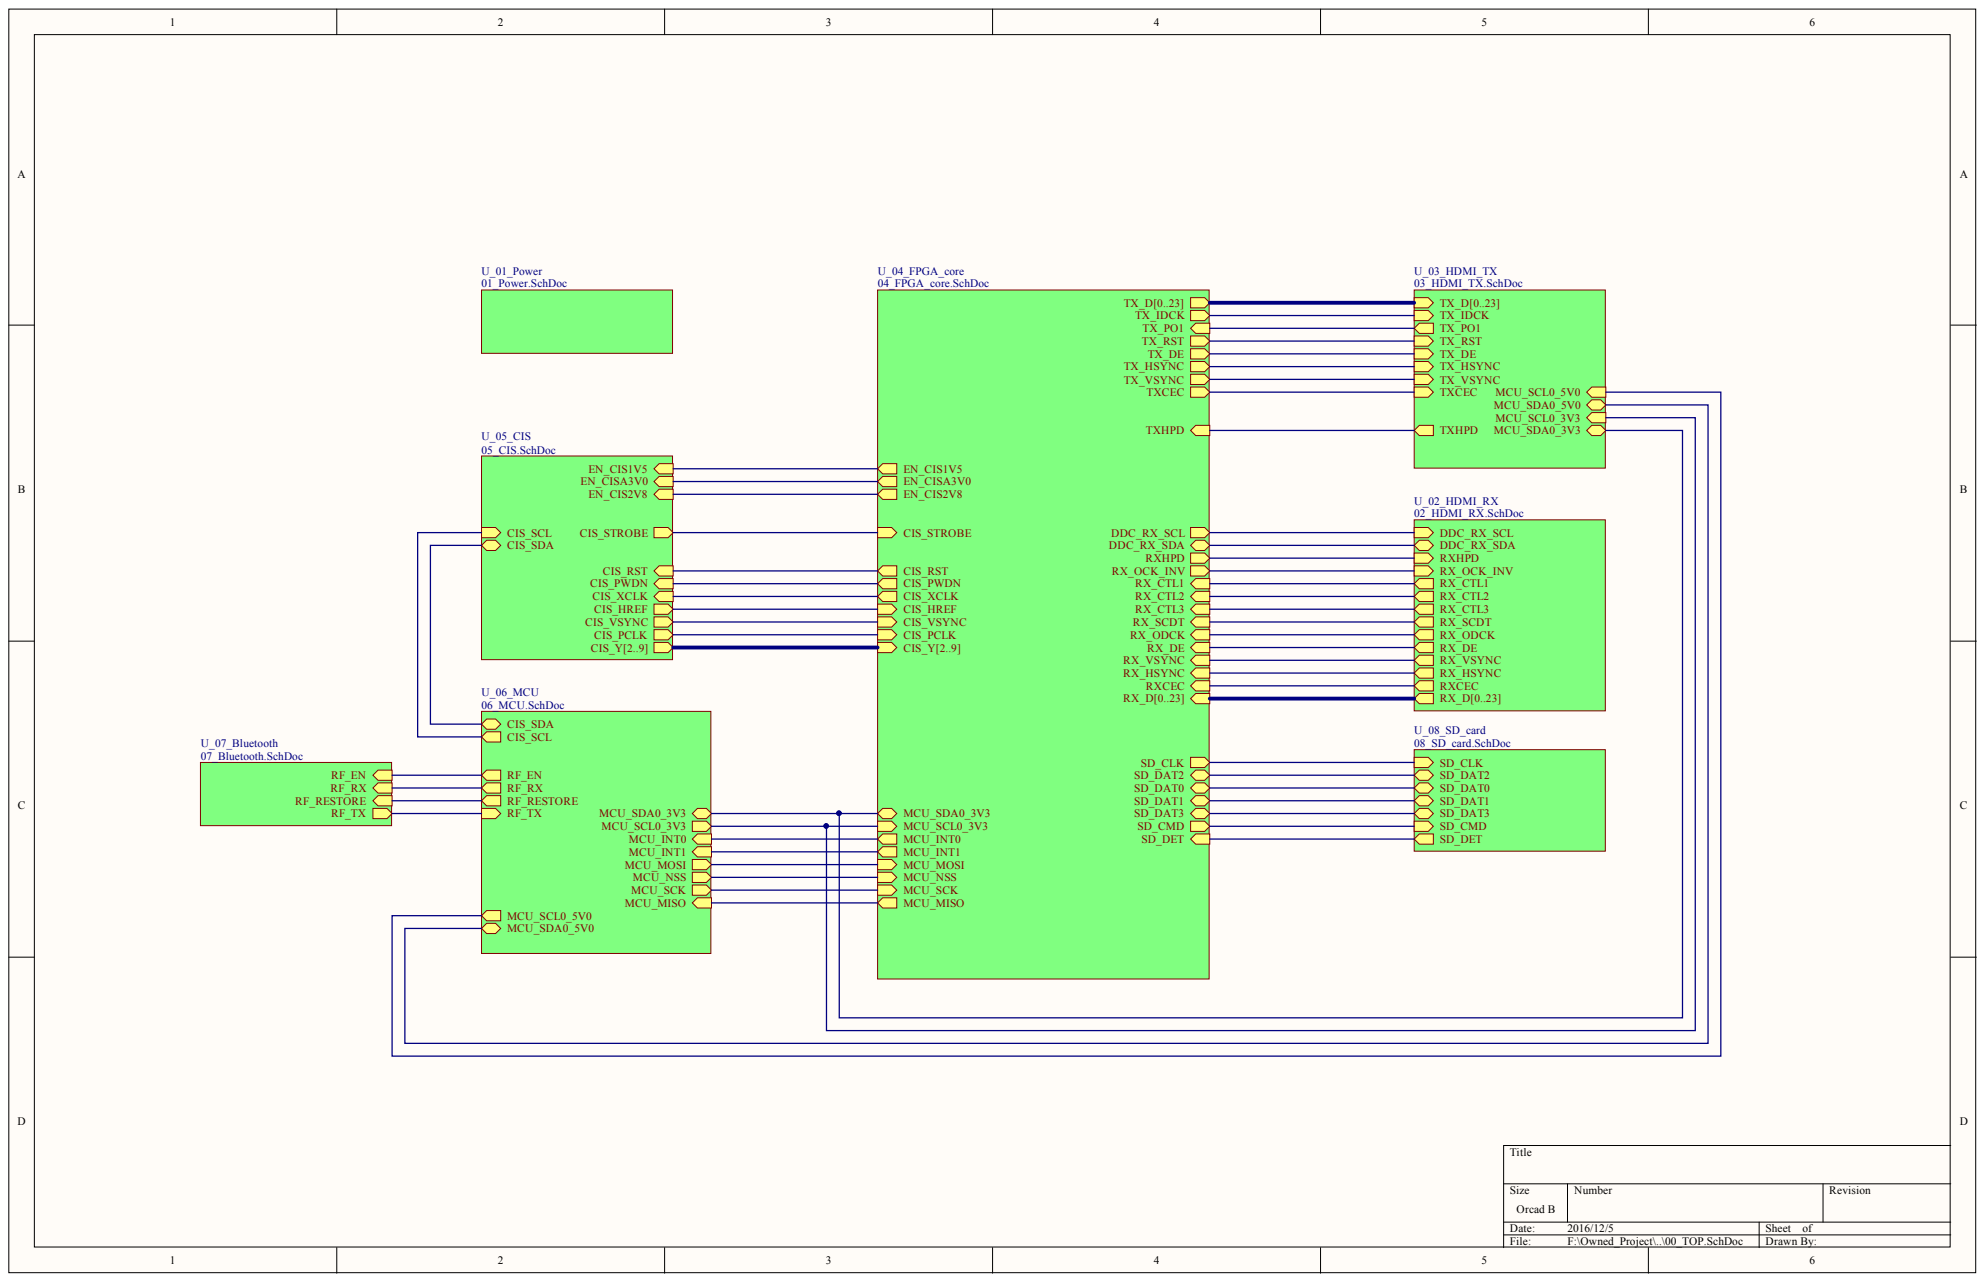
[picture p15: page 1]

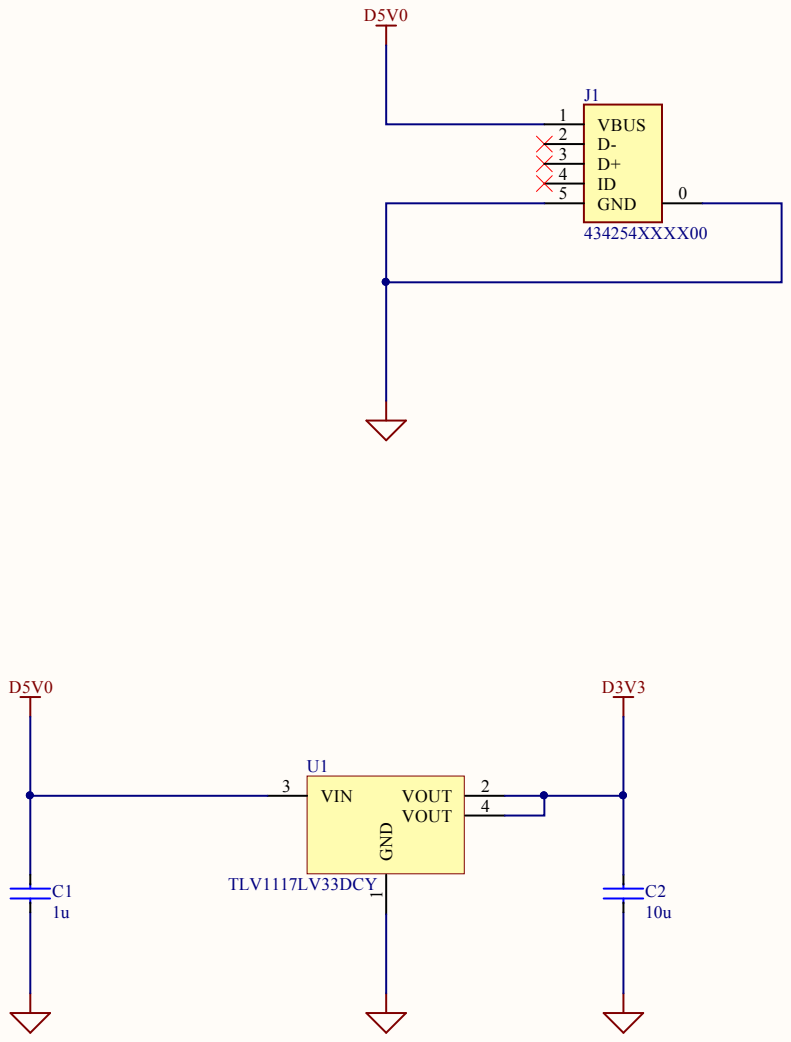
[picture p16: page 2]

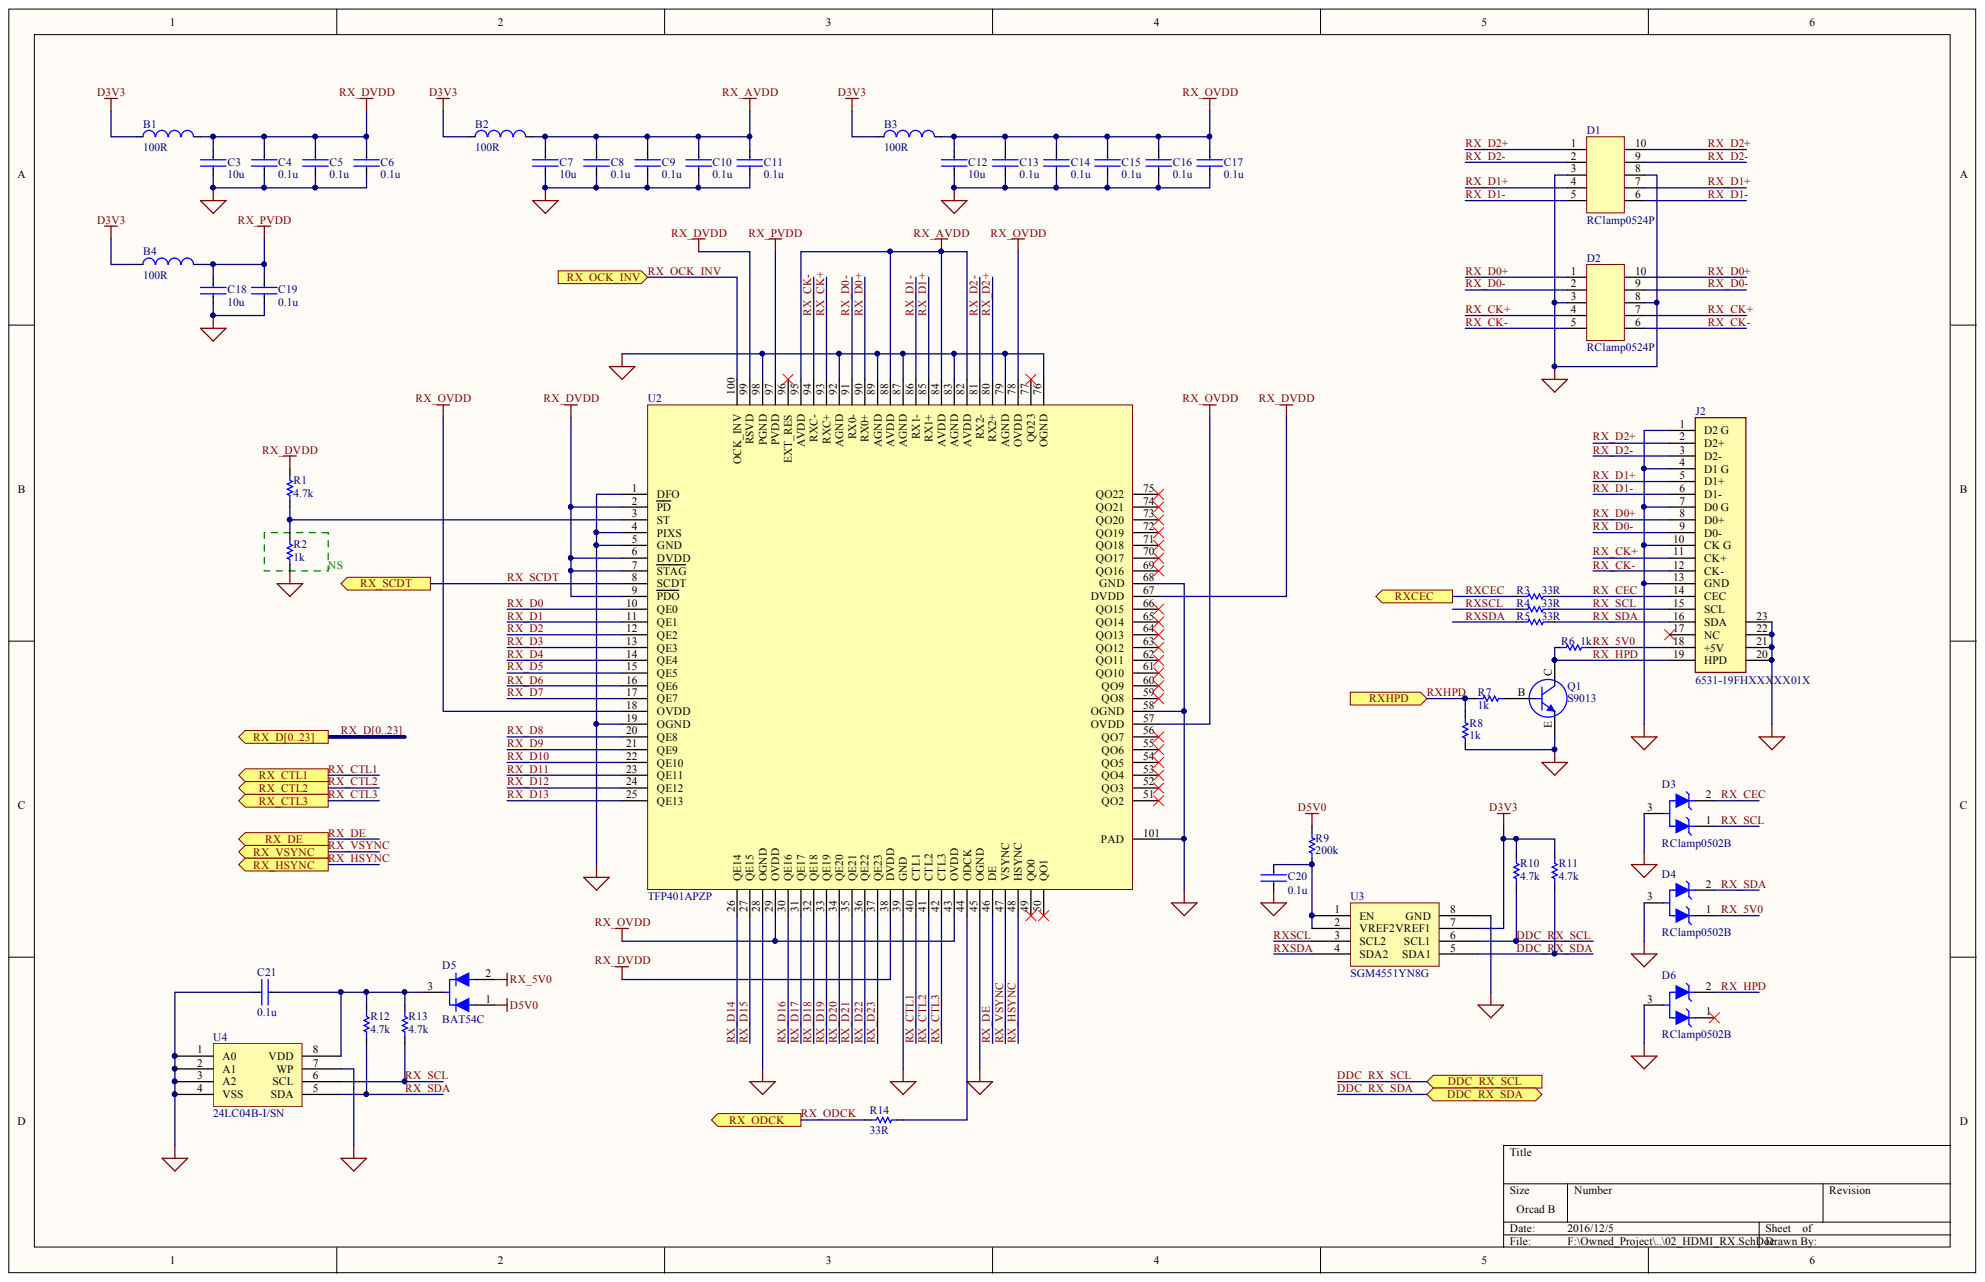
[picture p17: page 3]

OGND 76 QO23 77 OVDD 78 AGND 79 RX2+ 80 RX2- 81 AVDD 82 AGND 83 AVDD 84 RX1+ 85 RX1- 86 AGND 87 AVDD 88 AGND 89 RX0+ 90 RX0- 91 AGND 92 RXC+ 93 RXC- 94 AVDD 95 EXT_RES 96 PVDD 97 PGND 98 RSVD 99 OCK_INV 100

OVDD 18
OGND 19
QE8 20
QE9 21
QE10 22
QE11 23
QE12 24

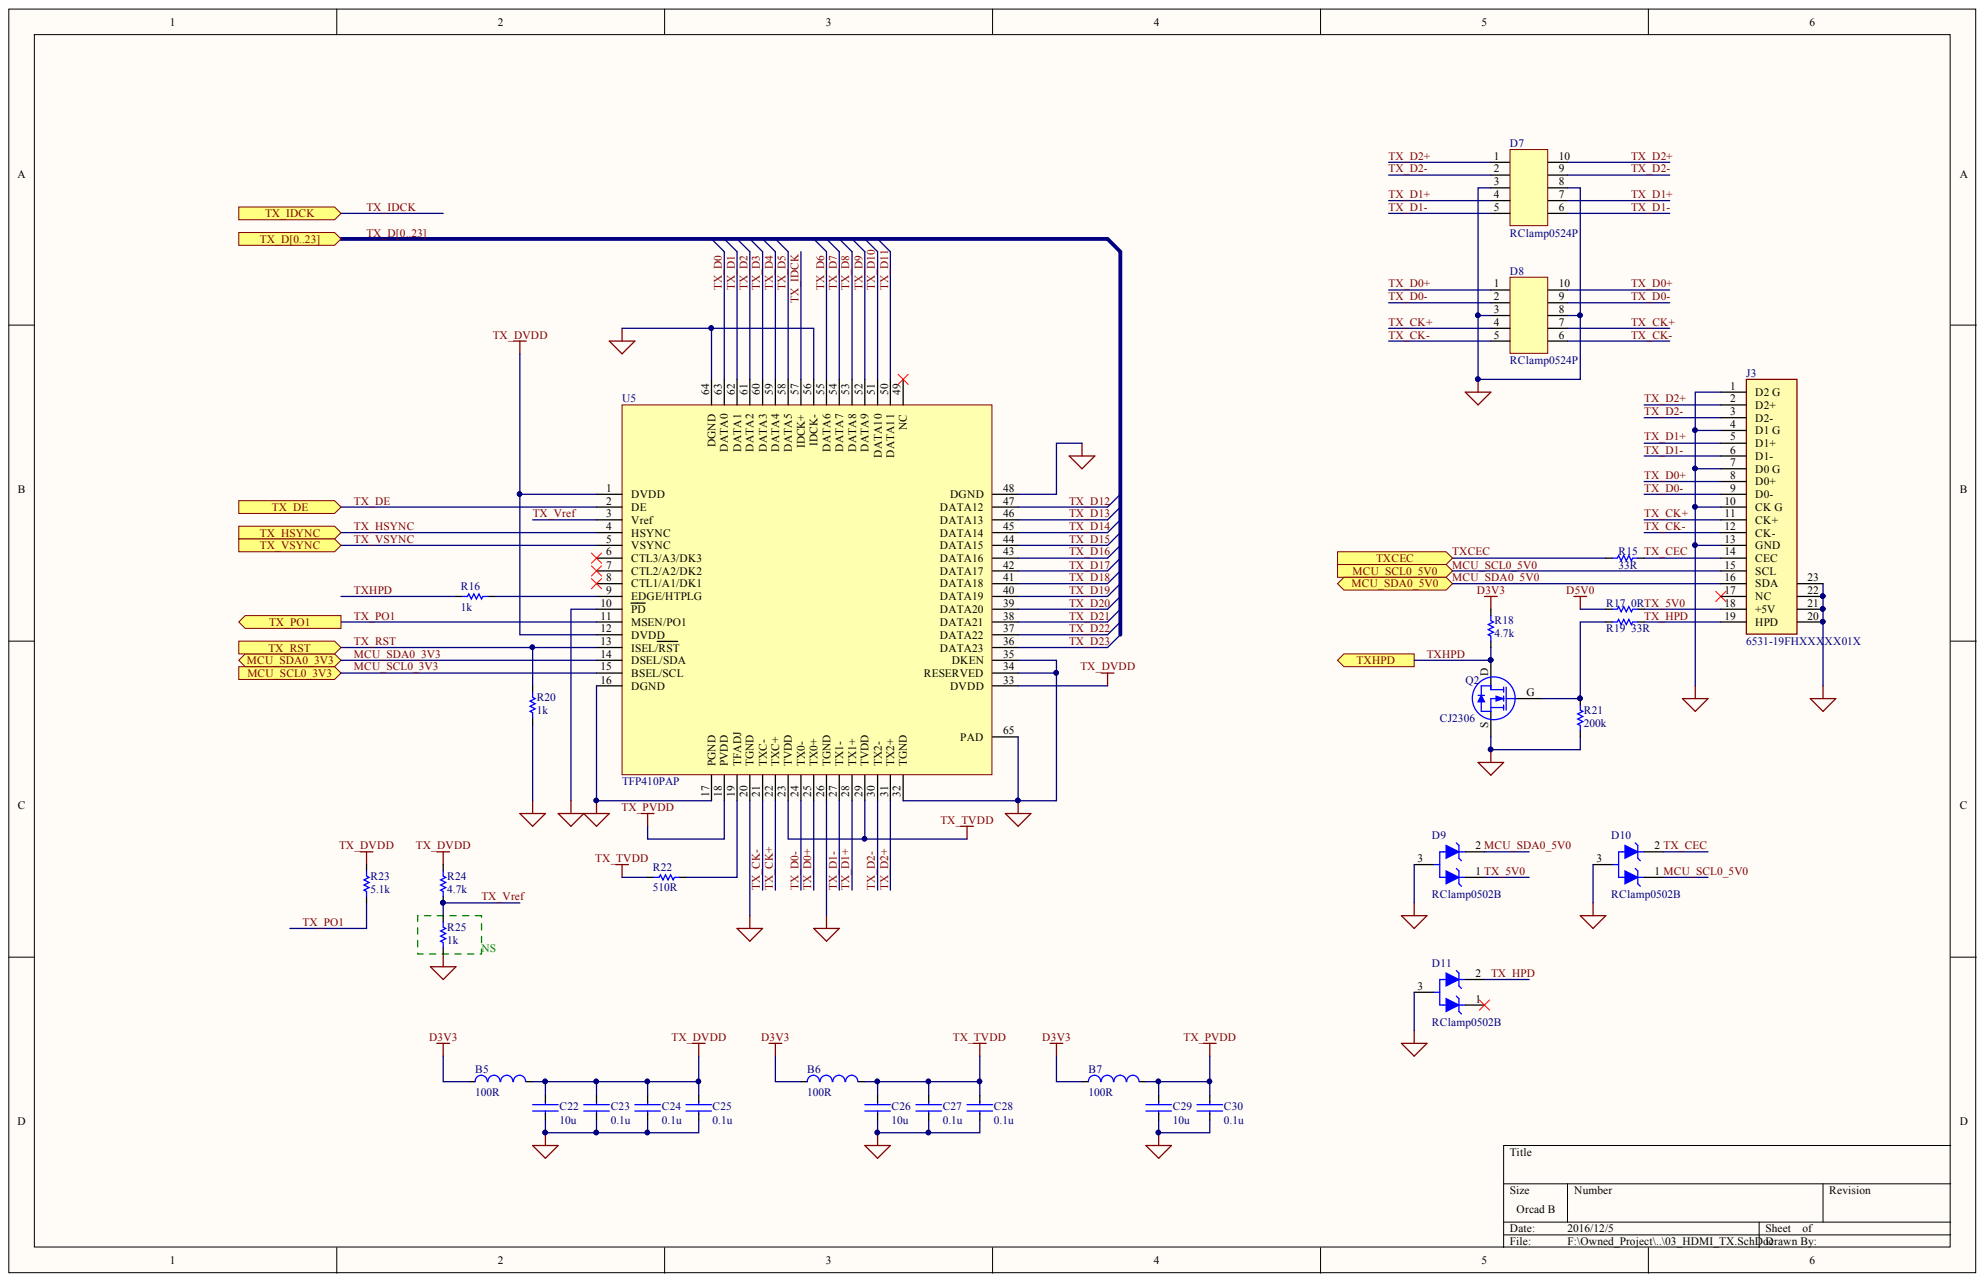
[picture p18: page 4]

NC 49 DATA11 50 DATA10 51 DATA9 52 DATA8 53 DATA7 54 DATA6 55 IDCK- 56 IDCK+ 57 DATA5 58 DATA4 59 DATA3 60 DATA2 61 DATA1 62 DATA0 63 DGND 64

DVDD 12 | TX_D22
ISEL/RST 13 | TX_D23

BSEL/SCL 15
DGND 16

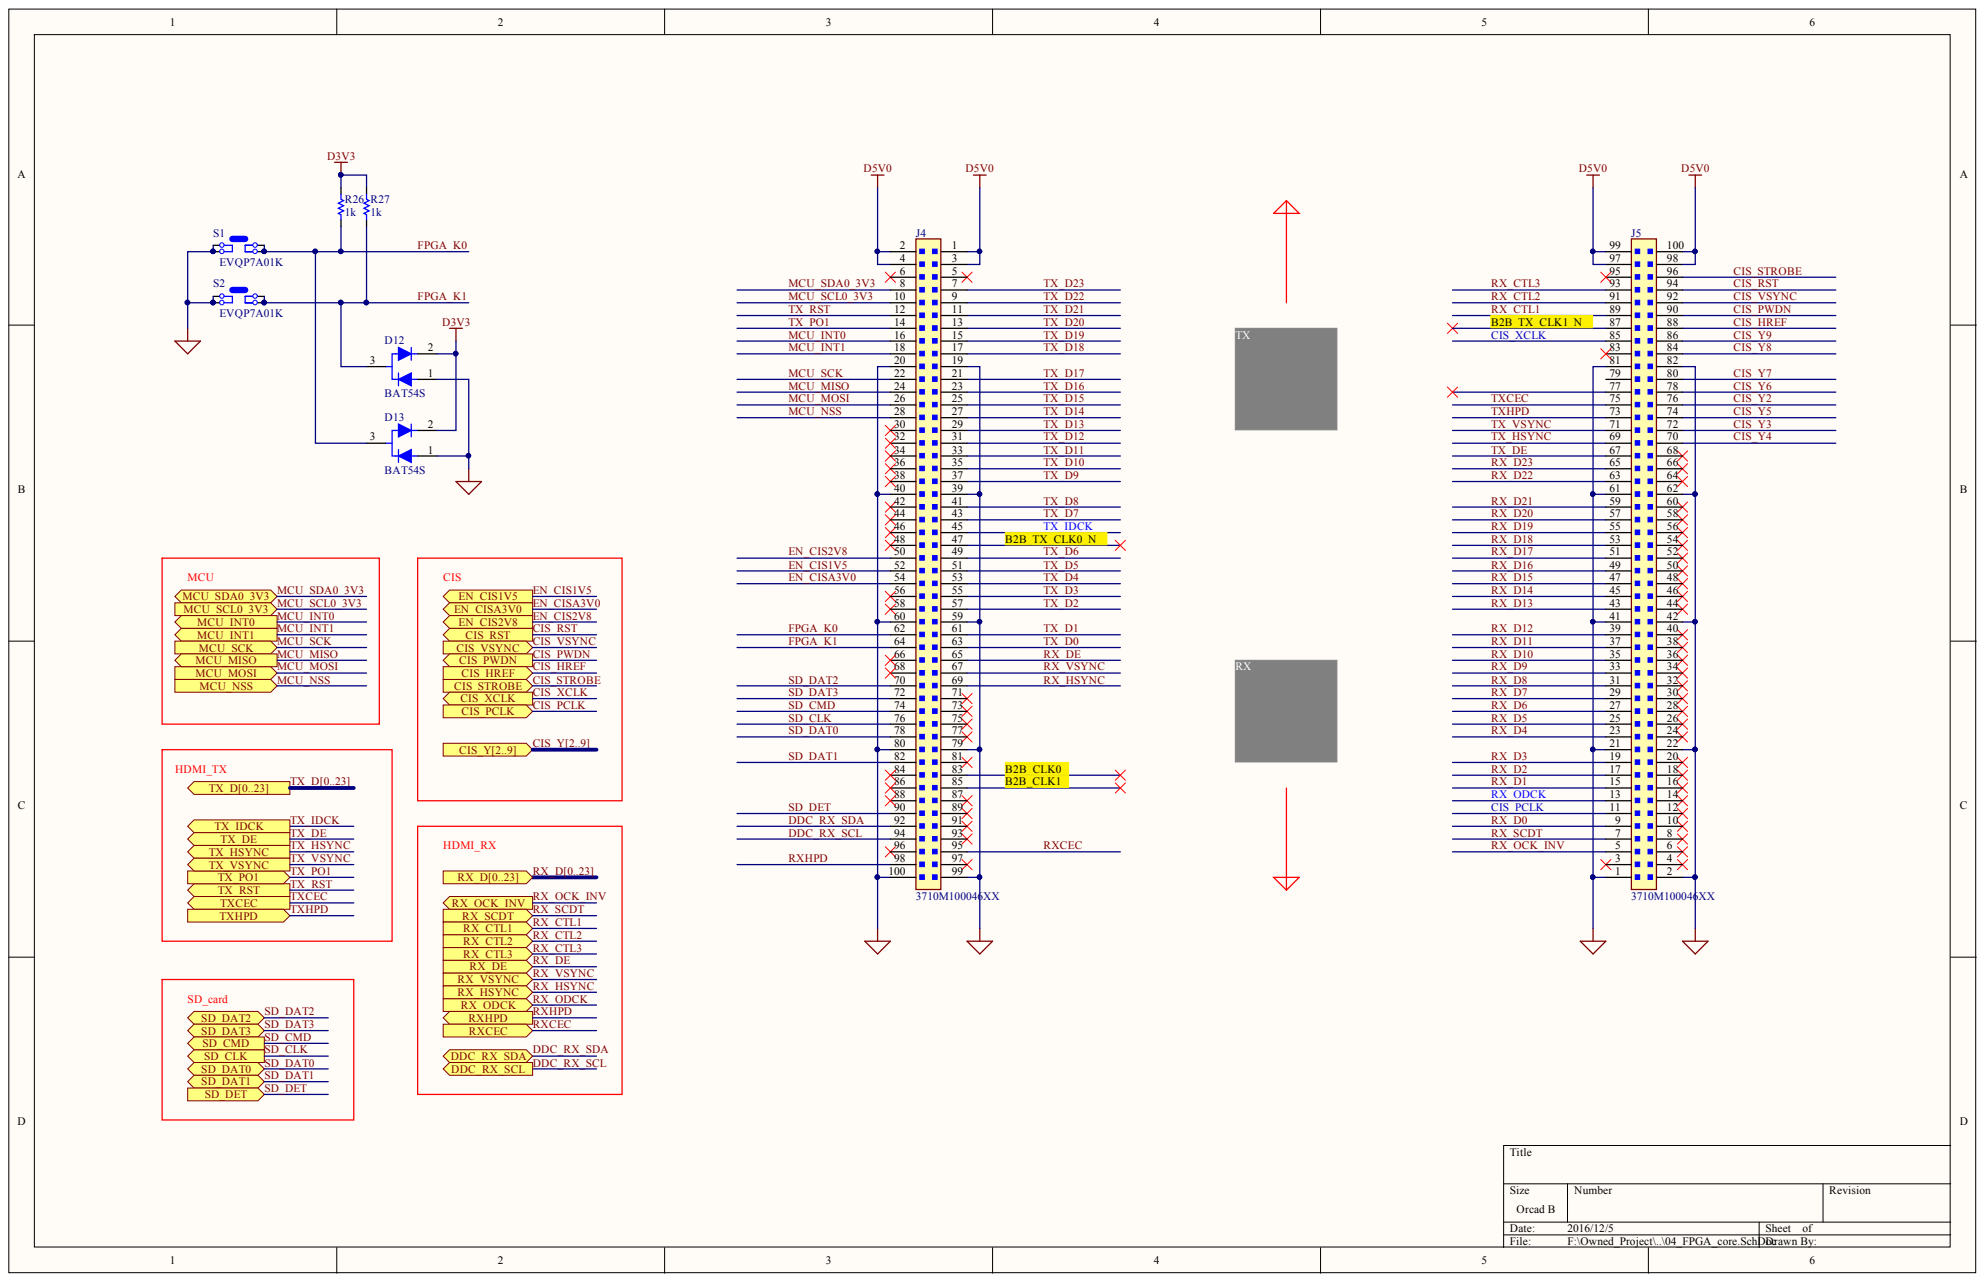
[picture p19: page 5]

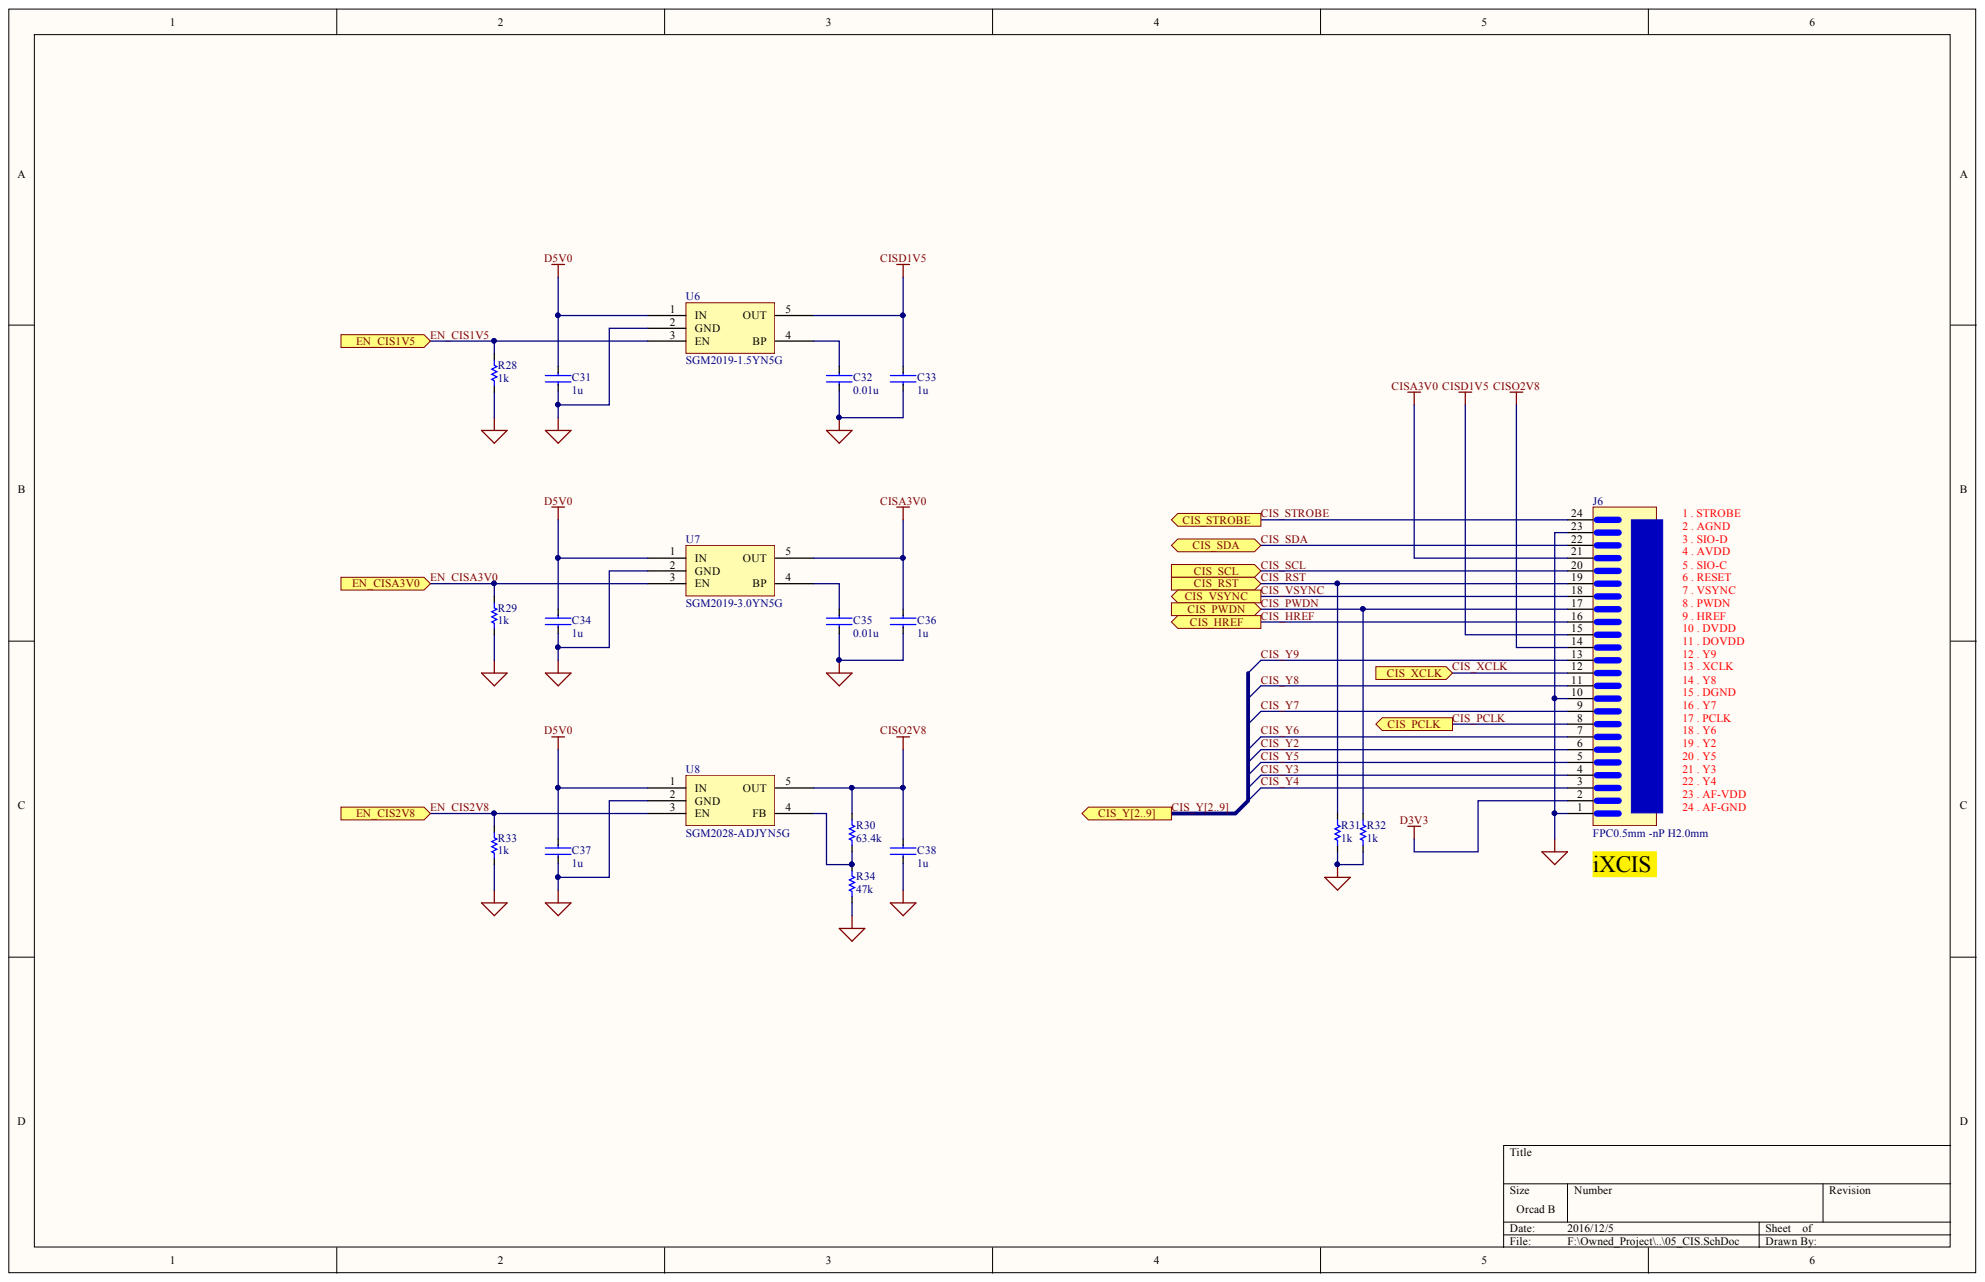
[picture p20: page 6]

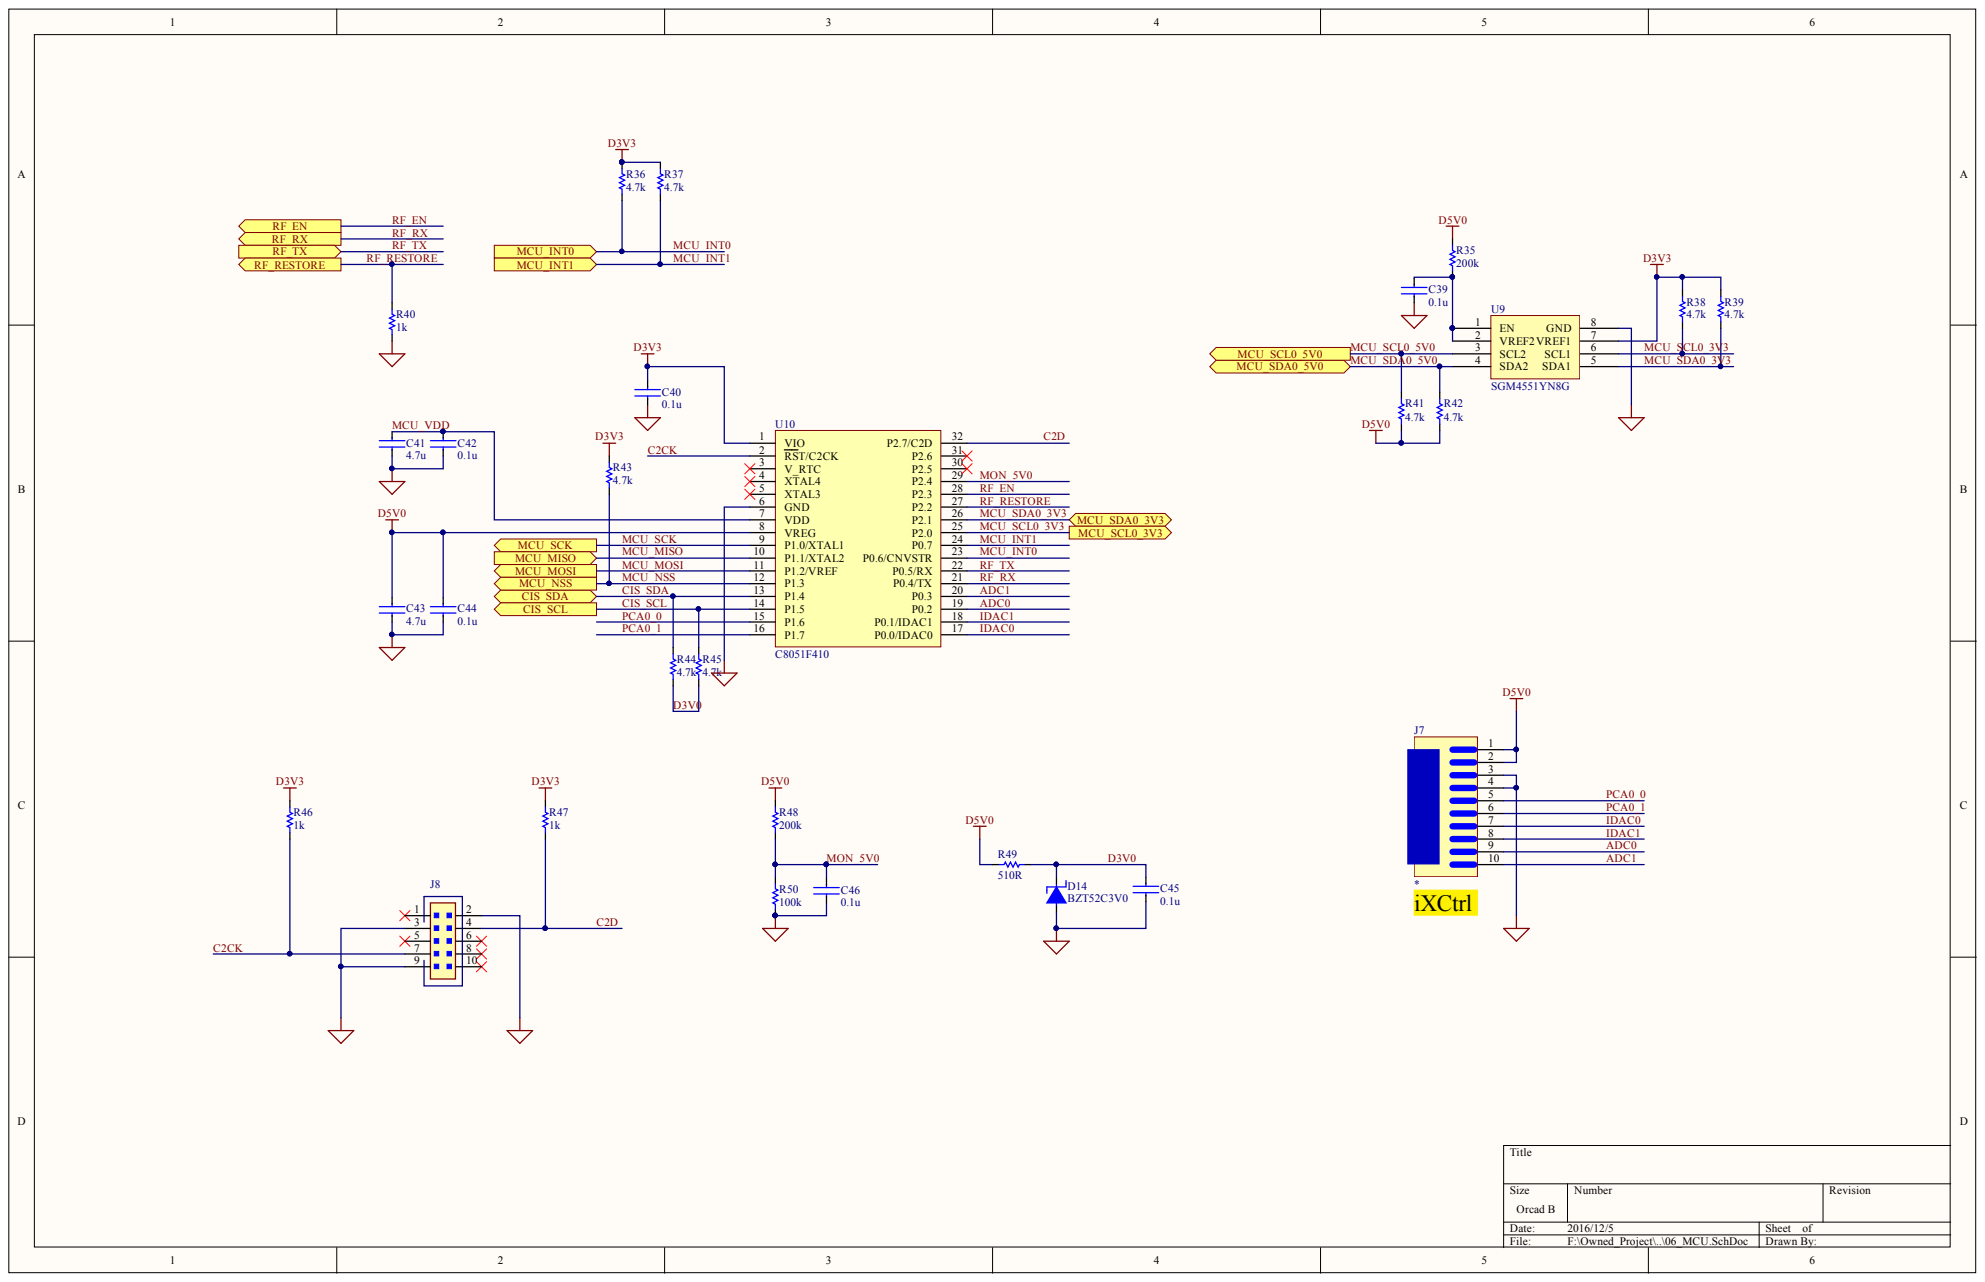
[picture p21: page 7]

VDD 7 VREG 8

CIS_SDA | P1.0/XTAL1 9 P1.1/XTAL2 10 P1.2/VREF 11 P1.3 12 P1.4 13 P1.5 14 P1.6 15

10

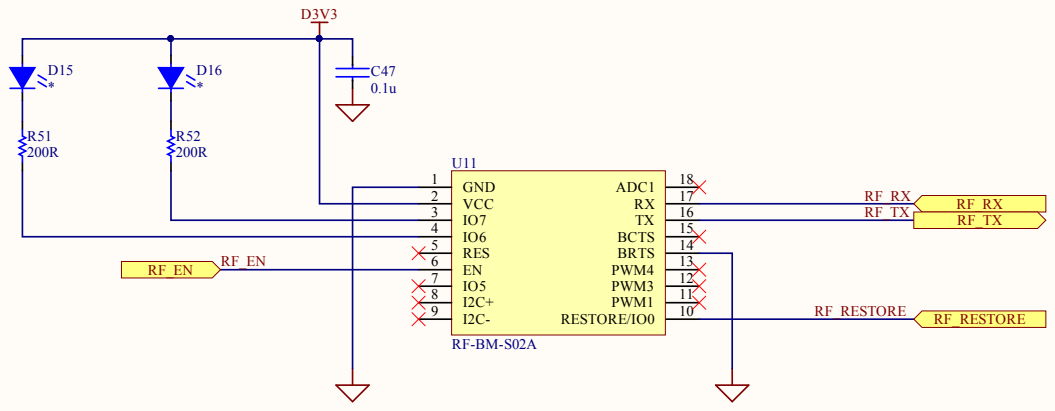
[picture p22: page 8]

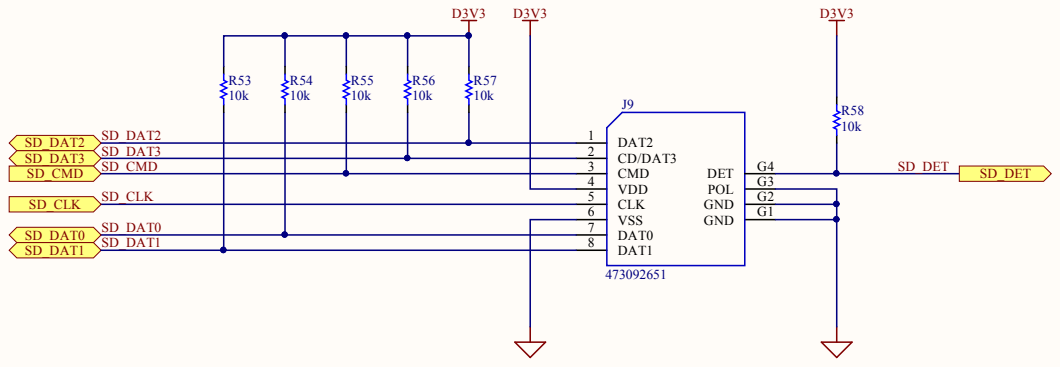
[picture p23: page 9]
