CoreyChen922/rggber-hw/(list of files, drawings)

Other design files:
FPGA_CORE_BOARD/SCH/00_TOP.SchDoc
FPGA_CORE_BOARD/SCH/01_POWER.SchDoc
FPGA_CORE_BOARD/SCH/02_USB2UART.SchDoc
FPGA_CORE_BOARD/SCH/03_BANK_1_2.SchDoc
FPGA_CORE_BOARD/SCH/04_BANK_3_4.SchDoc
FPGA_CORE_BOARD/SCH/05_BANK_5_6.SchDoc
FPGA_CORE_BOARD/SCH/06_BANK_7_8.SchDoc
FPGA_CORE_BOARD/SCH/07_CONFIG.SchDoc
FPGA_CORE_BOARD/SCH/08_DDR2.SchDoc
IMAGE_BASE_BOARD/SCH/00_TOP.SchDoc
IMAGE_BASE_BOARD/SCH/01_Power.SchDoc
IMAGE_BASE_BOARD/SCH/02_HDMI_RX.SchDoc
IMAGE_BASE_BOARD/SCH/03_HDMI_TX.SchDoc
IMAGE_BASE_BOARD/SCH/04_FPGA_core.SchDoc
IMAGE_BASE_BOARD/SCH/05_CIS.SchDoc
IMAGE_BASE_BOARD/SCH/06_MCU.SchDoc
IMAGE_BASE_BOARD/SCH/07_Bluetooth.SchDoc
IMAGE_BASE_BOARD/SCH/08_SD_card.SchDoc
iXCtrl_add_on/schematic/01.SchDoc
iXCtrl_add_on/schematic/02.SchDoc
LCD_add_on/schematic/01.SchDoc
LCD_add_on/schematic/02.SchDoc
