CoreyChen922/rggber-hw/(commit log)

2016-12-25 initial upload, all the documentations are Ver00
    [00_TOP.SchDoc, 0100_01_510020_000.xlsx, 0100_01_510020_001.xlsx, 01_POWER.SchDoc, 01_Power.SchDoc, 02_HDMI_RX.SchDoc, 02_USB2UART.SchDoc, 03_BANK_1_2.SchDoc]
2017-08-16 new upload
    [01.SchDoc, 0100_01_510020_002.xlsx, 02.SchDoc]
